shmoergh/moduleur/modules/06-utils-output/experimental/ui-l+r-out/utils-output-ui.kicad_pcb

## KiCad design modules/06-utils-output/experimental/ui-l+r-out/utils-output-ui.kicad_pcb (2026-05-13)

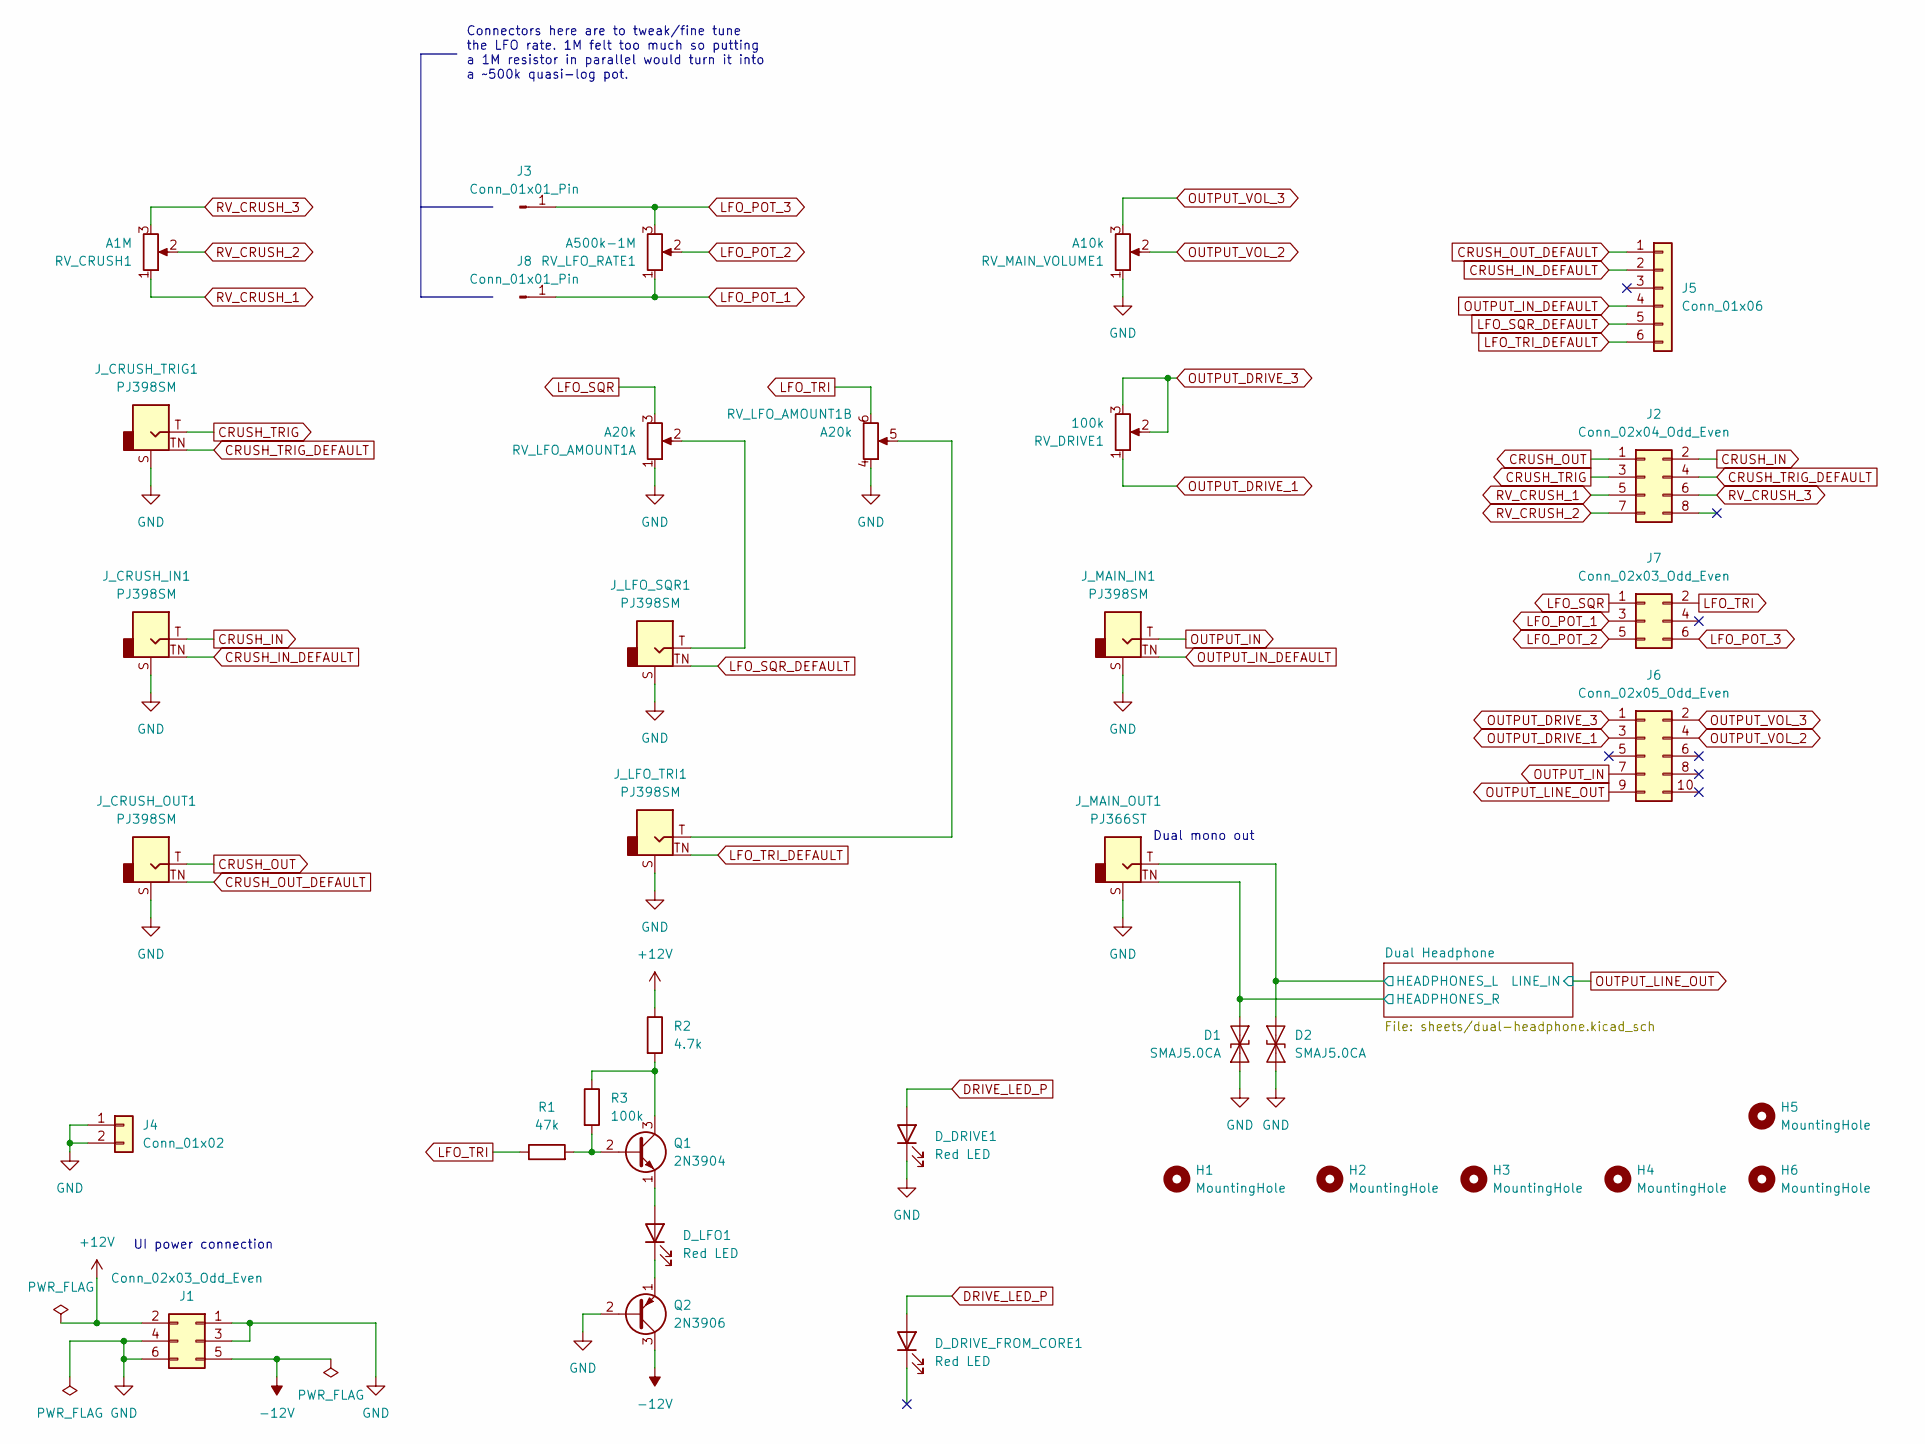
[picture p18: schematic utils-output-ui.kicad_sch, Utils + Output UI]

Parts:
D1, D2: SMAJ5.0CA; D_SMA
D_DRIVE1: Red LED; LED_D3.0mm
D_DRIVE_FROM_CORE1: Red LED; PinSocket_1x02_P2.54mm_Vertical
D_LFO1: Red LED; LED_D3.0mm
H1, H2, H3, H4, H5, H6: MountingHole; MountingHole_3.2mm_M3_DIN965_Pad
J1, J7: Conn_02x03_Odd_Even; PinSocket_2x03_P2.54mm_Vertical; Part no. 200-SSW10301TD
J2: Conn_02x04_Odd_Even; PinSocket_2x04_P2.54mm_Vertical; Part no. 200-SSW10401TD
J3, J8: Conn_01x01_Pin; TestPoint_THTPad_D2.0mm_Drill1.0mm
J4: Conn_01x02; PinSocket_1x02_P2.54mm_Vertical; Part no. 200-SSW10201TS
J5: Conn_01x06; PinSocket_1x06_P2.54mm_Vertical; Part no. 200-SSW10601TS
J6: Conn_02x05_Odd_Even; PinSocket_2x05_P2.54mm_Vertical; Part no. 200-SSW10501TD
J_CRUSH_IN1: PJ398SM; Jack_3.5mm_QingPu_WQP-PJ398SM_Vertical_CircularHoles; Part no. PJ398SM
J_CRUSH_OUT1: PJ398SM; Jack_3.5mm_QingPu_WQP-PJ398SM_Vertical_CircularHoles; Part no. PJ398SM
J_CRUSH_TRIG1: PJ398SM; Jack_3.5mm_QingPu_WQP-PJ398SM_Vertical_CircularHoles; Part no. PJ398SM
J_LFO_SQR1: PJ398SM; Jack_3.5mm_QingPu_WQP-PJ398SM_Vertical_CircularHoles; Part no. PJ398SM
J_LFO_TRI1: PJ398SM; Jack_3.5mm_QingPu_WQP-PJ398SM_Vertical_CircularHoles; Part no. PJ398SM
J_MAIN_IN1: PJ398SM; Jack_3.5mm_QingPu_WQP-PJ398SM_Vertical_CircularHoles; Part no. PJ398SM
J_MAIN_OUT1: PJ366ST; Jack_3.5mm_QingPu_WQP-PJ398SM_Vertical_CircularHoles; Part no. PJ366ST
Q1: 2N3904; TO-92_Inline_Wide; Part no. 637-2N3904
Q2: 2N3906; TO-92_Inline_Wide; Part no. 637-2N3906
R1: 47k; R_Axial_DIN0207_L6.3mm_D2.5mm_P7.62mm_Horizontal; Part no. 603-MFR-25FRF52-47K
R2: 4.7k; R_Axial_DIN0207_L6.3mm_D2.5mm_P7.62mm_Horizontal; Part no. 603-MFR25SFTF52-4K7
R3: 100k; R_Axial_DIN0207_L6.3mm_D2.5mm_P7.62mm_Horizontal; Part no. 603-MFR25SFTF52-4K7
RV_CRUSH1: A1M; Potentiometer_Bourns_Single-PTV09A; Part no. 652-PTV09A4025FA105
RV_DRIVE1: 100k; Potentiometer_Bourns_Single-PTV09A; Part no. 652-PTV09A4025UB104
RV_LFO_AMOUNT1: A20k; Potentiometer_Bourns_Dual-PTV112-4; Part No. 652-PTV1124425AA203
RV_LFO_RATE1: A500k-1M; Potentiometer_Bourns_Single-PTV09A; Part no. 652-PTV09A4025FA105
RV_MAIN_VOLUME1: A10k; Potentiometer_Bourns_Single-PTV09A; Part no. 652-PTV09A4025FA103

Connections:
+12V: J1.2, R2.1; also elsewhere on the board
-12V: J1.5, Q2.3 (C); also elsewhere on the board
/Dual Headphone/HEADPHONES_L: D2.2 (A2), J_MAIN_OUT1.T; also elsewhere on the board
/Dual Headphone/HEADPHONES_R: D1.2 (A2), J_MAIN_OUT1.TN; also elsewhere on the board
CRUSH_IN: J2.2, J_CRUSH_IN1.T
CRUSH_IN_DEFAULT: J5.2, J_CRUSH_IN1.TN
CRUSH_OUT: J2.1, J_CRUSH_OUT1.T
CRUSH_OUT_DEFAULT: J5.1, J_CRUSH_OUT1.TN
CRUSH_TRIG: J2.3, J_CRUSH_TRIG1.T
CRUSH_TRIG_DEFAULT: J2.4, J_CRUSH_TRIG1.TN
DRIVE_LED_P: D_DRIVE1.2 (A), D_DRIVE_FROM_CORE1.2 (A_2)
GND: D1.1 (A1), D2.1 (A1), D_DRIVE1.1 (K), J1.1, J1.3, J1.4, J1.6, J4.1, J4.2, J_CRUSH_IN1.S, J_CRUSH_OUT1.S, J_CRUSH_TRIG1.S, J_LFO_SQR1.S, J_LFO_TRI1.S, J_MAIN_IN1.S, J_MAIN_OUT1.S, Q2.2 (B), RV_LFO_AMOUNT1.1, RV_LFO_AMOUNT1.4, RV_MAIN_VOLUME1.1; also elsewhere on the board
LFO_POT_1: J7.3, J8.1 (Pin_1_1), RV_LFO_RATE1.1
LFO_POT_2: J7.5, RV_LFO_RATE1.2
LFO_POT_3: J3.1 (Pin_1_1), J7.6, RV_LFO_RATE1.3
LFO_SQR: J7.1, RV_LFO_AMOUNT1.3
LFO_SQR_DEFAULT: J5.5, J_LFO_SQR1.TN
LFO_TRI: J7.2, R1.1, RV_LFO_AMOUNT1.6
LFO_TRI_DEFAULT: J5.6, J_LFO_TRI1.TN
unnamed: D_LFO1.2 (A), Q1.1 (E)
unnamed: D_LFO1.1 (K), Q2.1 (E)
unnamed: J_LFO_SQR1.T, RV_LFO_AMOUNT1.2
unnamed: J_LFO_TRI1.T, RV_LFO_AMOUNT1.5
unnamed: Q1.2 (B), R1.2, R3.2
unnamed: Q1.3 (C), R2.2, R3.1
OUTPUT_DRIVE_1: J6.3, RV_DRIVE1.1
OUTPUT_DRIVE_3: J6.1, RV_DRIVE1.2, RV_DRIVE1.3
OUTPUT_IN: J6.7, J_MAIN_IN1.T
OUTPUT_IN_DEFAULT: J5.4, J_MAIN_IN1.TN
OUTPUT_LINE_OUT: J6.9; also elsewhere on the board
OUTPUT_VOL_2: J6.4, RV_MAIN_VOLUME1.2
OUTPUT_VOL_3: J6.2, RV_MAIN_VOLUME1.3
RV_CRUSH_1: J2.5, RV_CRUSH1.1
RV_CRUSH_2: J2.7, RV_CRUSH1.2
RV_CRUSH_3: J2.6, RV_CRUSH1.3

Notes on the sheet:
Dual mono out
Connectors here are to tweak/fine tune the LFO rate. 1M felt too much so putting a 1M resistor in parallel would turn it into a ~500k quasi-log pot.
UI power connection

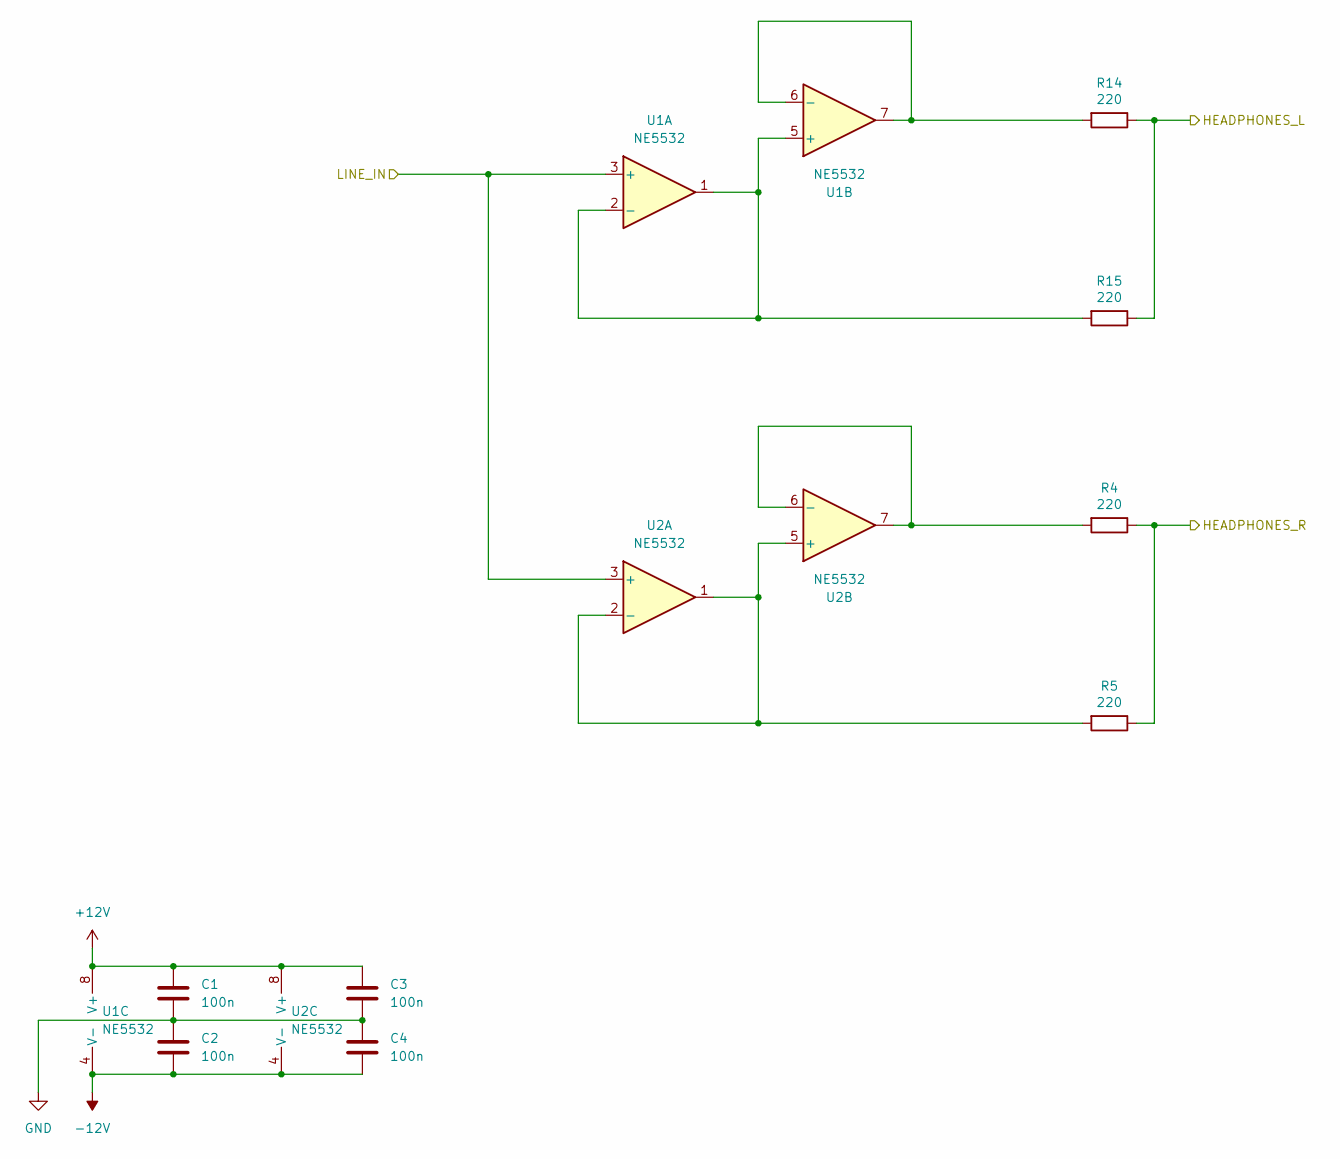
[picture p19: schematic dual-headphone.kicad_sch, Utils + Output UI]

Parts:
C1, C2, C3, C4: 100n; C_1206_3216Metric_Pad1.33x1.80mm_HandSolder; Part No. 80-C1206C104J5RAC
R4, R5, R14, R15: 220; R_1206_3216Metric_Pad1.30x1.75mm_HandSolder; Part No. 652-CR1206JW-221ELF
U1, U2: NE5532; SOIC-8_3.9x4.9mm_P1.27mm; Part No. 595-NE5532DR

Connections:
+12V: C1.1, C3.1, U1.8 (V+), U2.8 (V+); also elsewhere on the board
-12V: C2.2, C4.2, U1.4 (V-), U2.4 (V-); also elsewhere on the board
/Dual Headphone/HEADPHONES_L: R14.1, R15.1; also elsewhere on the board
/Dual Headphone/HEADPHONES_R: R4.1, R5.1; also elsewhere on the board
GND: C1.2, C2.1, C3.2, C4.1; also elsewhere on the board
unnamed: R15.2, U1.1, U1.2 (-), U1.5 (+)
unnamed: R14.2, U1.6 (-), U1.7
unnamed: R5.2, U2.1, U2.2 (-), U2.5 (+)
unnamed: R4.2, U2.6 (-), U2.7
OUTPUT_LINE_OUT: U1.3 (+), U2.3 (+); also elsewhere on the board

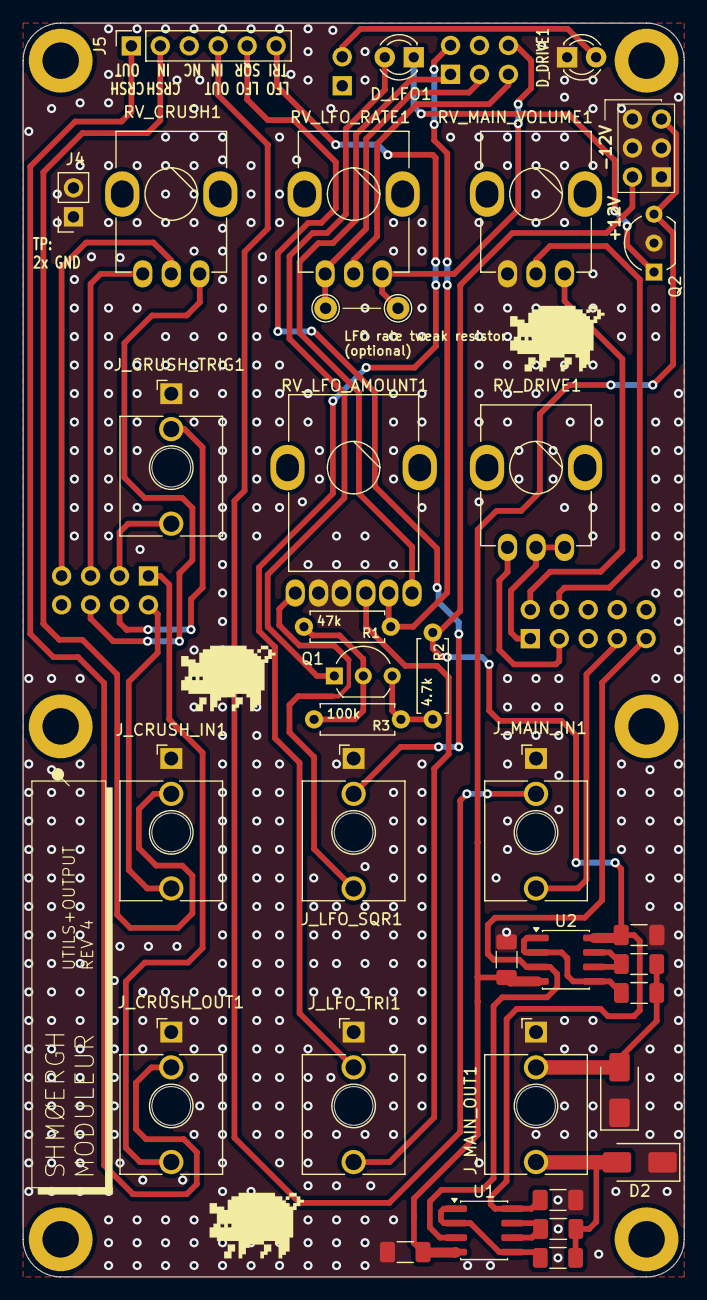
[picture p20: board utils-output-ui.kicad_pcb from above]

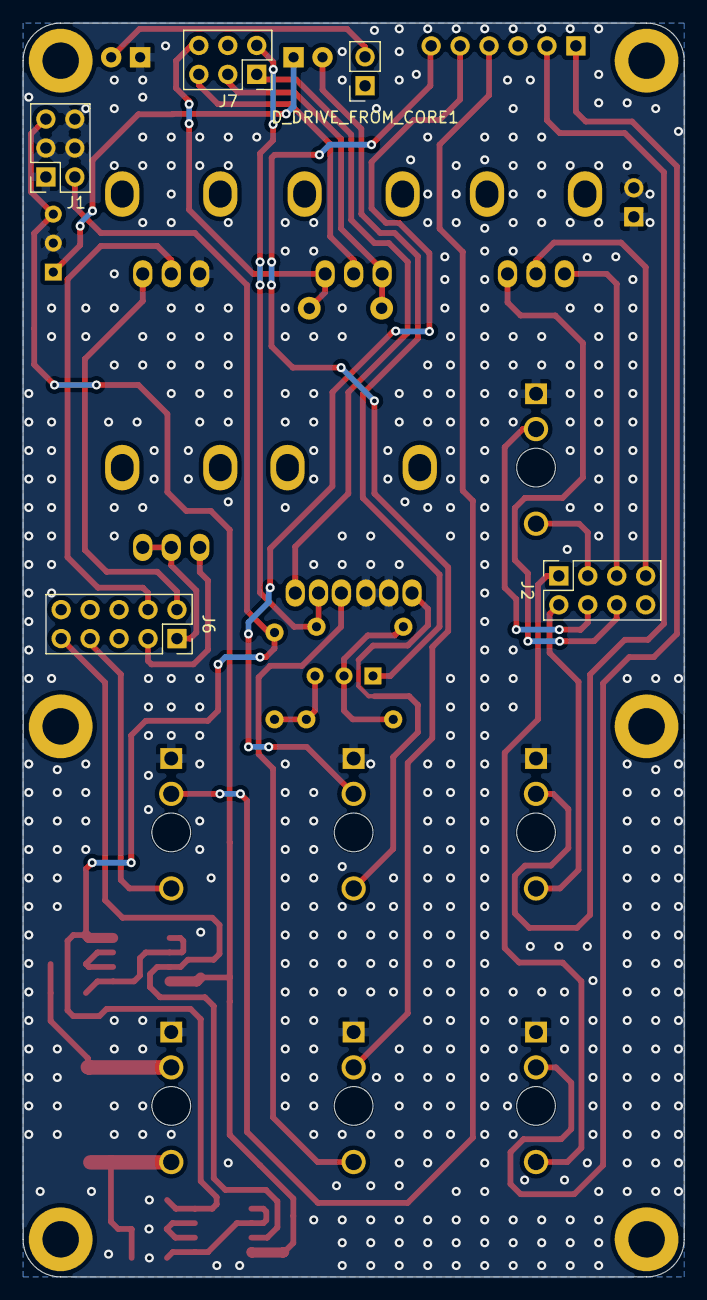
[picture p21: board utils-output-ui.kicad_pcb from below]

Board: 2 copper layers, 58.0 x 110.0 mm, 46 parts (5 on the bottom side), 39 nets.
