shmoergh/moduleur/modules/05-adsr-vca/electronics/ui/adsr-vca-ui.kicad_pcb

## KiCad design modules/05-adsr-vca/electronics/ui/adsr-vca-ui.kicad_pcb (2026-05-13)

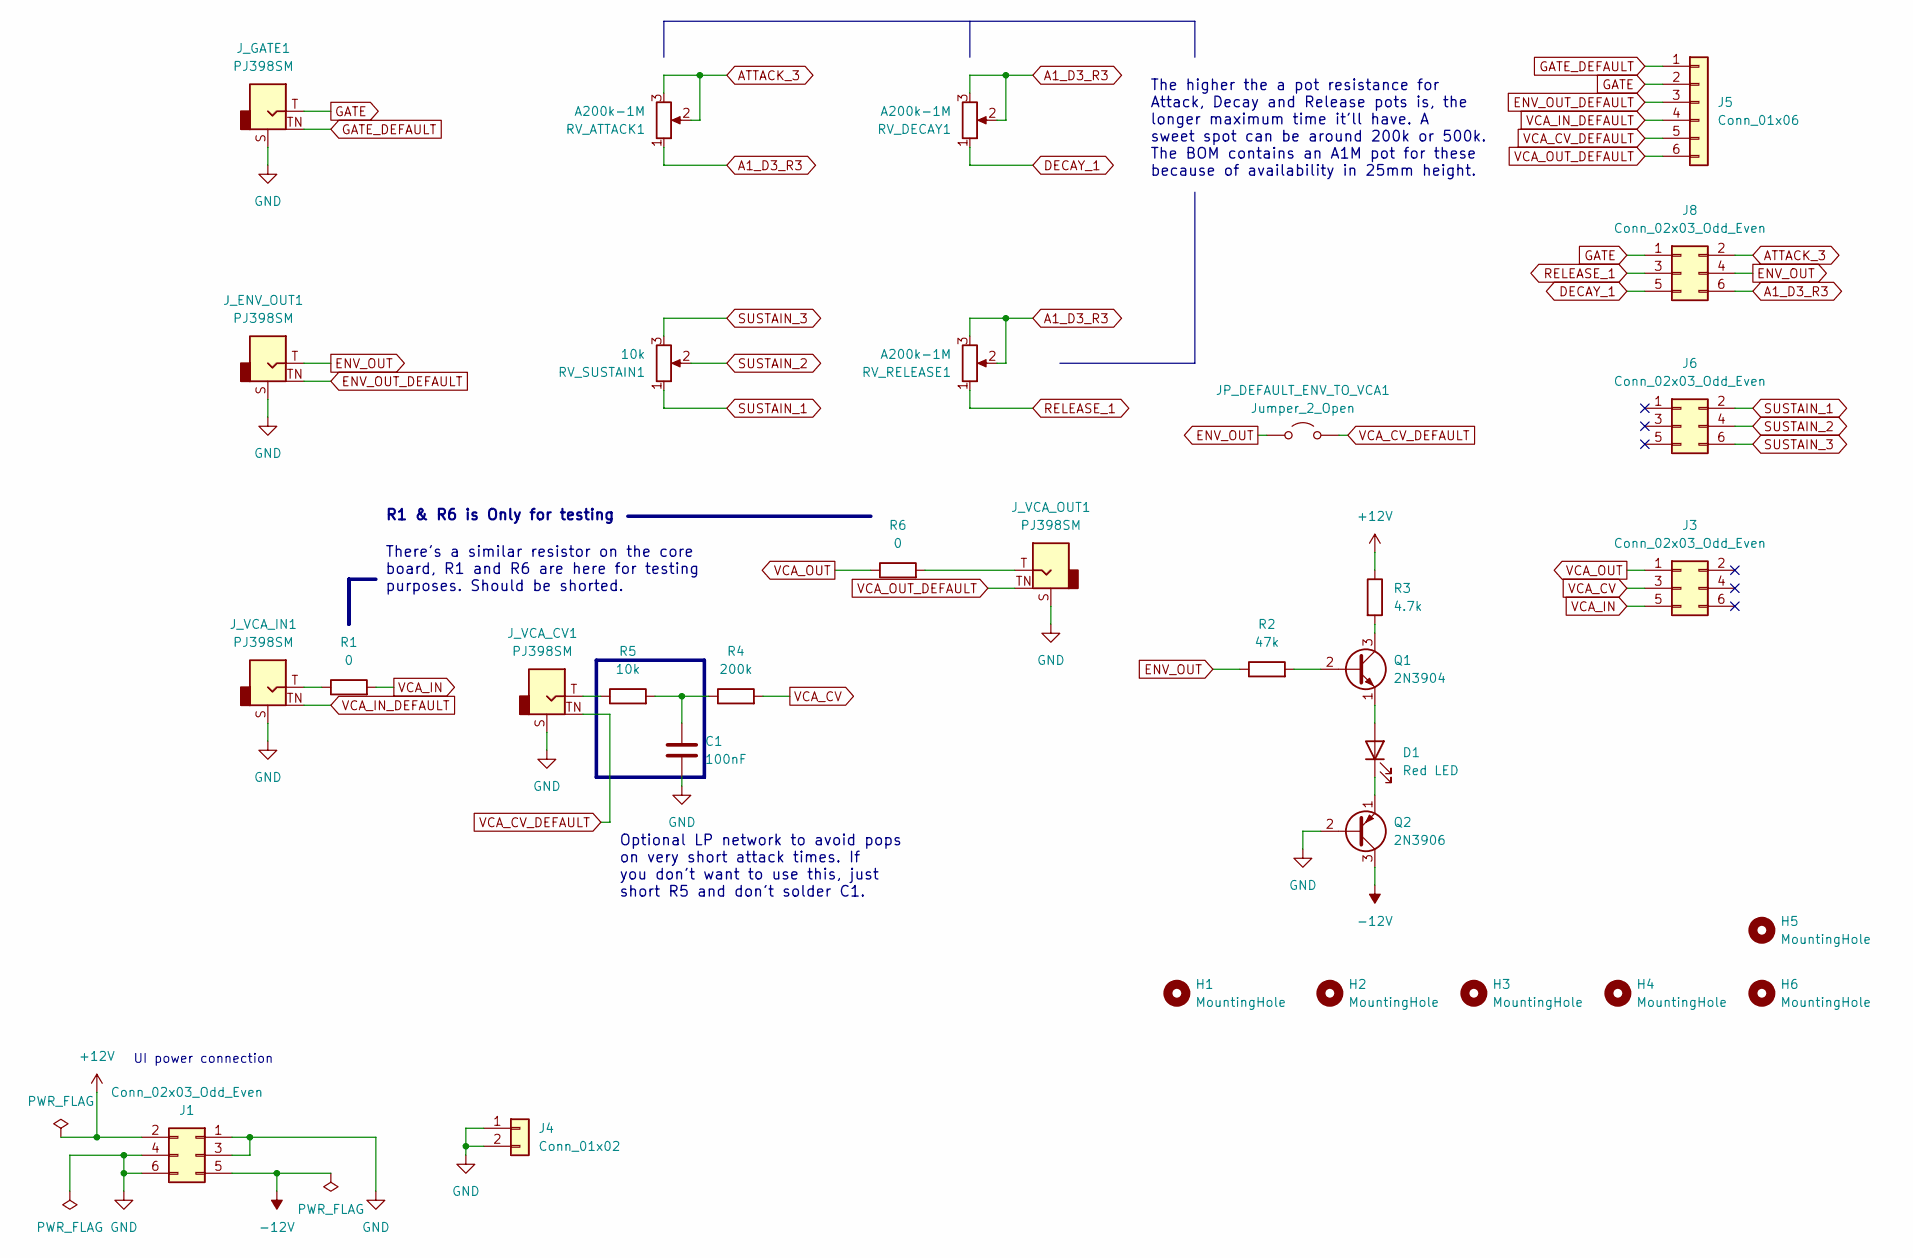
[picture p28: schematic adsr-vca-ui.kicad_sch, ADSR + VCA UI]

Parts:
C1: 100nF; C_Rect_L7.2mm_W2.5mm_P5.00mm_FKS2_FKP2_MKS2_MKP2; Part no. 80-MMK5104J50J01L16
D1: Red LED; LED_D3.0mm
H1, H2, H3, H4, H5, H6: MountingHole; MountingHole_3.2mm_M3_DIN965_Pad
J1, J3, J6, J8: Conn_02x03_Odd_Even; PinSocket_2x03_P2.54mm_Vertical; Part no. 200-SSW10301TD
J4: Conn_01x02; PinSocket_1x02_P2.54mm_Vertical; Part no. 200-SSW10201TS
J5: Conn_01x06; PinSocket_1x06_P2.54mm_Vertical; Part no. 200-SSW10601TS
JP_DEFAULT_ENV_TO_VCA1: Jumper_2_Open; PinHeader_1x02_P2.54mm_Horizontal; Part no. 200-HTSW10208TSRA
J_ENV_OUT1: PJ398SM; Jack_3.5mm_QingPu_WQP-PJ398SM_Vertical_CircularHoles; Part no. PJ398SM
J_GATE1: PJ398SM; Jack_3.5mm_QingPu_WQP-PJ398SM_Vertical_CircularHoles; Part no. PJ398SM
J_VCA_CV1: PJ398SM; Jack_3.5mm_QingPu_WQP-PJ398SM_Vertical_CircularHoles; Part no. PJ398SM
J_VCA_IN1: PJ398SM; Jack_3.5mm_QingPu_WQP-PJ398SM_Vertical_CircularHoles; Part no. PJ398SM
J_VCA_OUT1: PJ398SM; Jack_3.5mm_QingPu_WQP-PJ398SM_Vertical_CircularHoles; Part no. PJ398SM
Q1: 2N3904; TO-92_Inline_Wide; Part no. 637-2N3904
Q2: 2N3906; TO-92_Inline_Wide; Part no. 637-2N3906
R1: 0; R_Axial_DIN0207_L6.3mm_D2.5mm_P7.62mm_Horizontal; Part no. 603-MFR-25FRF52100K
R2: 47k; R_Axial_DIN0207_L6.3mm_D2.5mm_P7.62mm_Horizontal; Part no. 603-MFR-25FRF52-47K
R3: 4.7k; R_Axial_DIN0207_L6.3mm_D2.5mm_P7.62mm_Horizontal; Part no. 603-MFR25SFTF52-4K7
R4: 200k; R_Axial_DIN0207_L6.3mm_D2.5mm_P7.62mm_Horizontal; Part no. 603-MFR-25FRF52200K
R5: 10k; R_Axial_DIN0207_L6.3mm_D2.5mm_P7.62mm_Horizontal; Part no. 603-MFR-25FRF5210K
R6: 0; R_Axial_DIN0207_L6.3mm_D2.5mm_P7.62mm_Horizontal; Part no. 603-MFR-25FRF52-47K
RV_ATTACK1: A200k-1M; Potentiometer_Bourns_Single-PTV09A; Part no. 652-PTV09A4025FA105
RV_DECAY1: A200k-1M; Potentiometer_Bourns_Single-PTV09A; Part no. 652-PTV09A4025FA105
RV_RELEASE1: A200k-1M; Potentiometer_Bourns_Single-PTV09A; Part no. 652-PTV09A4025FA105
RV_SUSTAIN1: 10k; TRIM_PTA4543-2015DPB103; Part no. 652-PTA4432015CPB103

Connections:
+12V: J1.2, R3.1
-12V: J1.5, Q2.3 (C)
A1_D3_R3: J8.6, RV_ATTACK1.1, RV_DECAY1.2, RV_DECAY1.3, RV_RELEASE1.2, RV_RELEASE1.3
ATTACK_3: J8.2, RV_ATTACK1.2, RV_ATTACK1.3
DECAY_1: J8.5, RV_DECAY1.1
ENV_OUT: J8.4, JP_DEFAULT_ENV_TO_VCA1.1 (A), J_ENV_OUT1.T, R2.1
ENV_OUT_DEFAULT: J5.3, J_ENV_OUT1.TN
GATE: J5.2, J8.1, J_GATE1.T
GATE_DEFAULT: J5.1, J_GATE1.TN
GND: C1.2, J1.1, J1.3, J1.4, J1.6, J4.1, J4.2, J_ENV_OUT1.S, J_GATE1.S, J_VCA_CV1.S, J_VCA_IN1.S, J_VCA_OUT1.S, Q2.2 (B)
unnamed: C1.1, R4.1, R5.2
unnamed: D1.2 (A), Q1.1 (E)
unnamed: D1.1 (K), Q2.1 (E)
unnamed: J_VCA_CV1.T, R5.1
unnamed: J_VCA_IN1.T, R1.1
unnamed: J_VCA_OUT1.T, R6.2
unnamed: Q1.2 (B), R2.2
unnamed: Q1.3 (C), R3.2
RELEASE_1: J8.3, RV_RELEASE1.1
SUSTAIN_1: J6.2, RV_SUSTAIN1.1
SUSTAIN_2: J6.4, RV_SUSTAIN1.2
SUSTAIN_3: J6.6, RV_SUSTAIN1.3
VCA_CV: J3.3, R4.2
VCA_CV_DEFAULT: J5.5, JP_DEFAULT_ENV_TO_VCA1.2 (B), J_VCA_CV1.TN
VCA_IN: J3.5, R1.2
VCA_IN_DEFAULT: J5.4, J_VCA_IN1.TN
VCA_OUT: J3.1, R6.1
VCA_OUT_DEFAULT: J5.6, J_VCA_OUT1.TN

Notes on the sheet:
There's a similar resistor on the core board, R1 and R6 are here for testing purposes. Should be shorted.
R1 & R6 is Only for testing
UI power connection
The higher the a pot resistance for Attack, Decay and Release pots is, the longer maximum time it'll have. A sweet spot can be around 200k or 500k. The BOM contains an A1M pot for these because of availability in 25mm height.
Optional LP network to avoid pops on very short attack times. If you don't want to use this, just short R5 and don't solder C1.

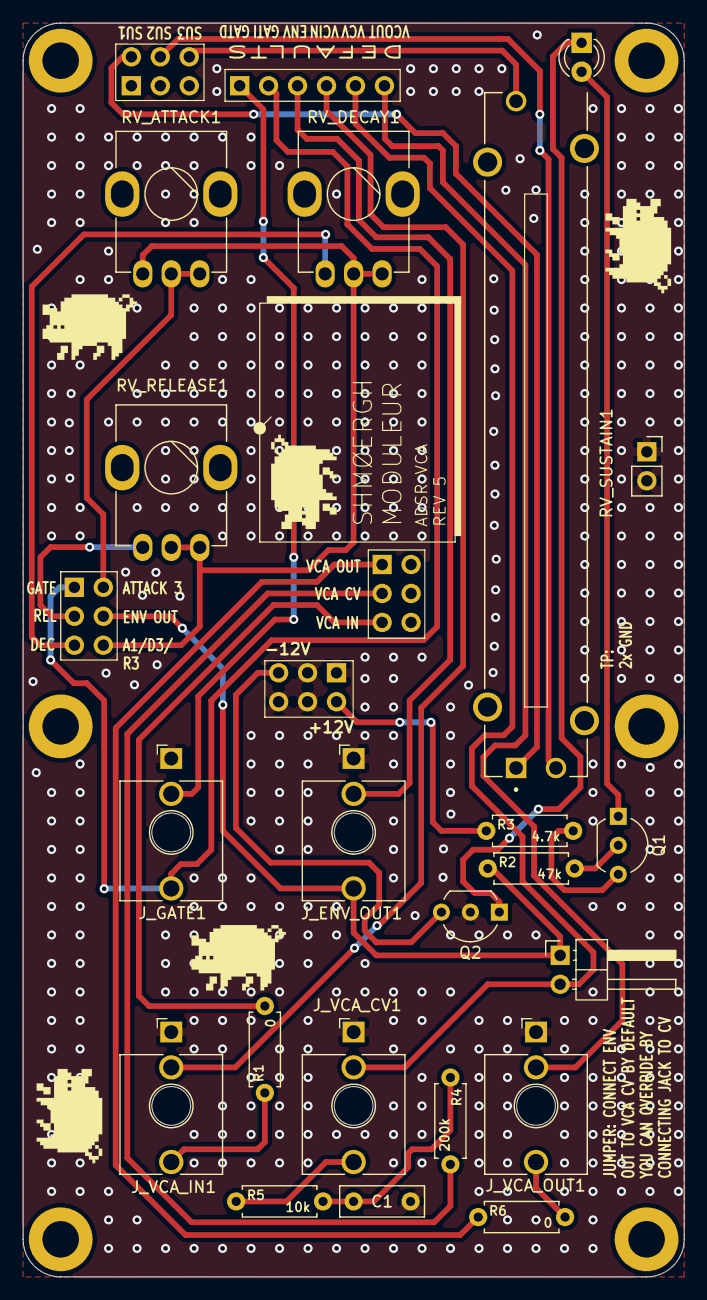
[picture p29: board adsr-vca-ui.kicad_pcb from above]

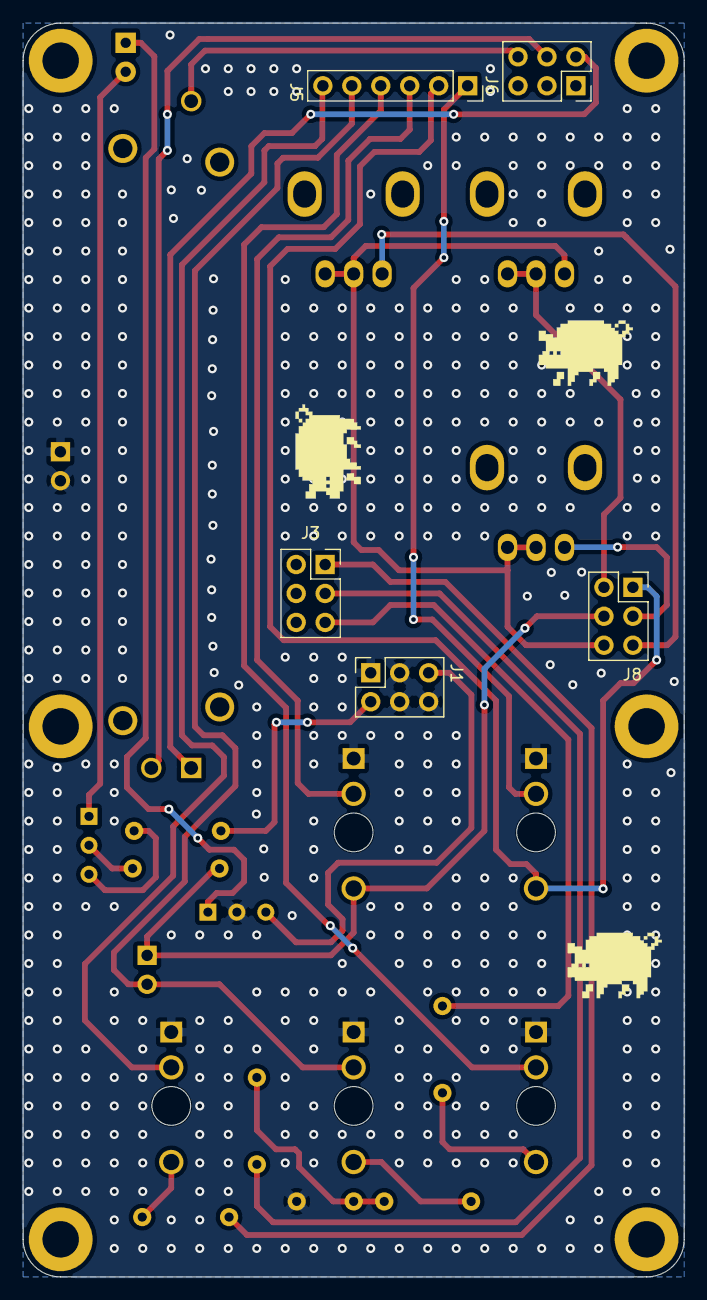
[picture p30: board adsr-vca-ui.kicad_pcb from below]

Board: 2 copper layers, 58.0 x 110.0 mm, 32 parts (5 on the bottom side), 28 nets.
