shmoergh/moduleur/modules/03-sidechain-mixer/electronics/core/sidechain-mixer-core.kicad_pcb

## KiCad design modules/03-sidechain-mixer/electronics/core/sidechain-mixer-core.kicad_pcb (2026-05-13)

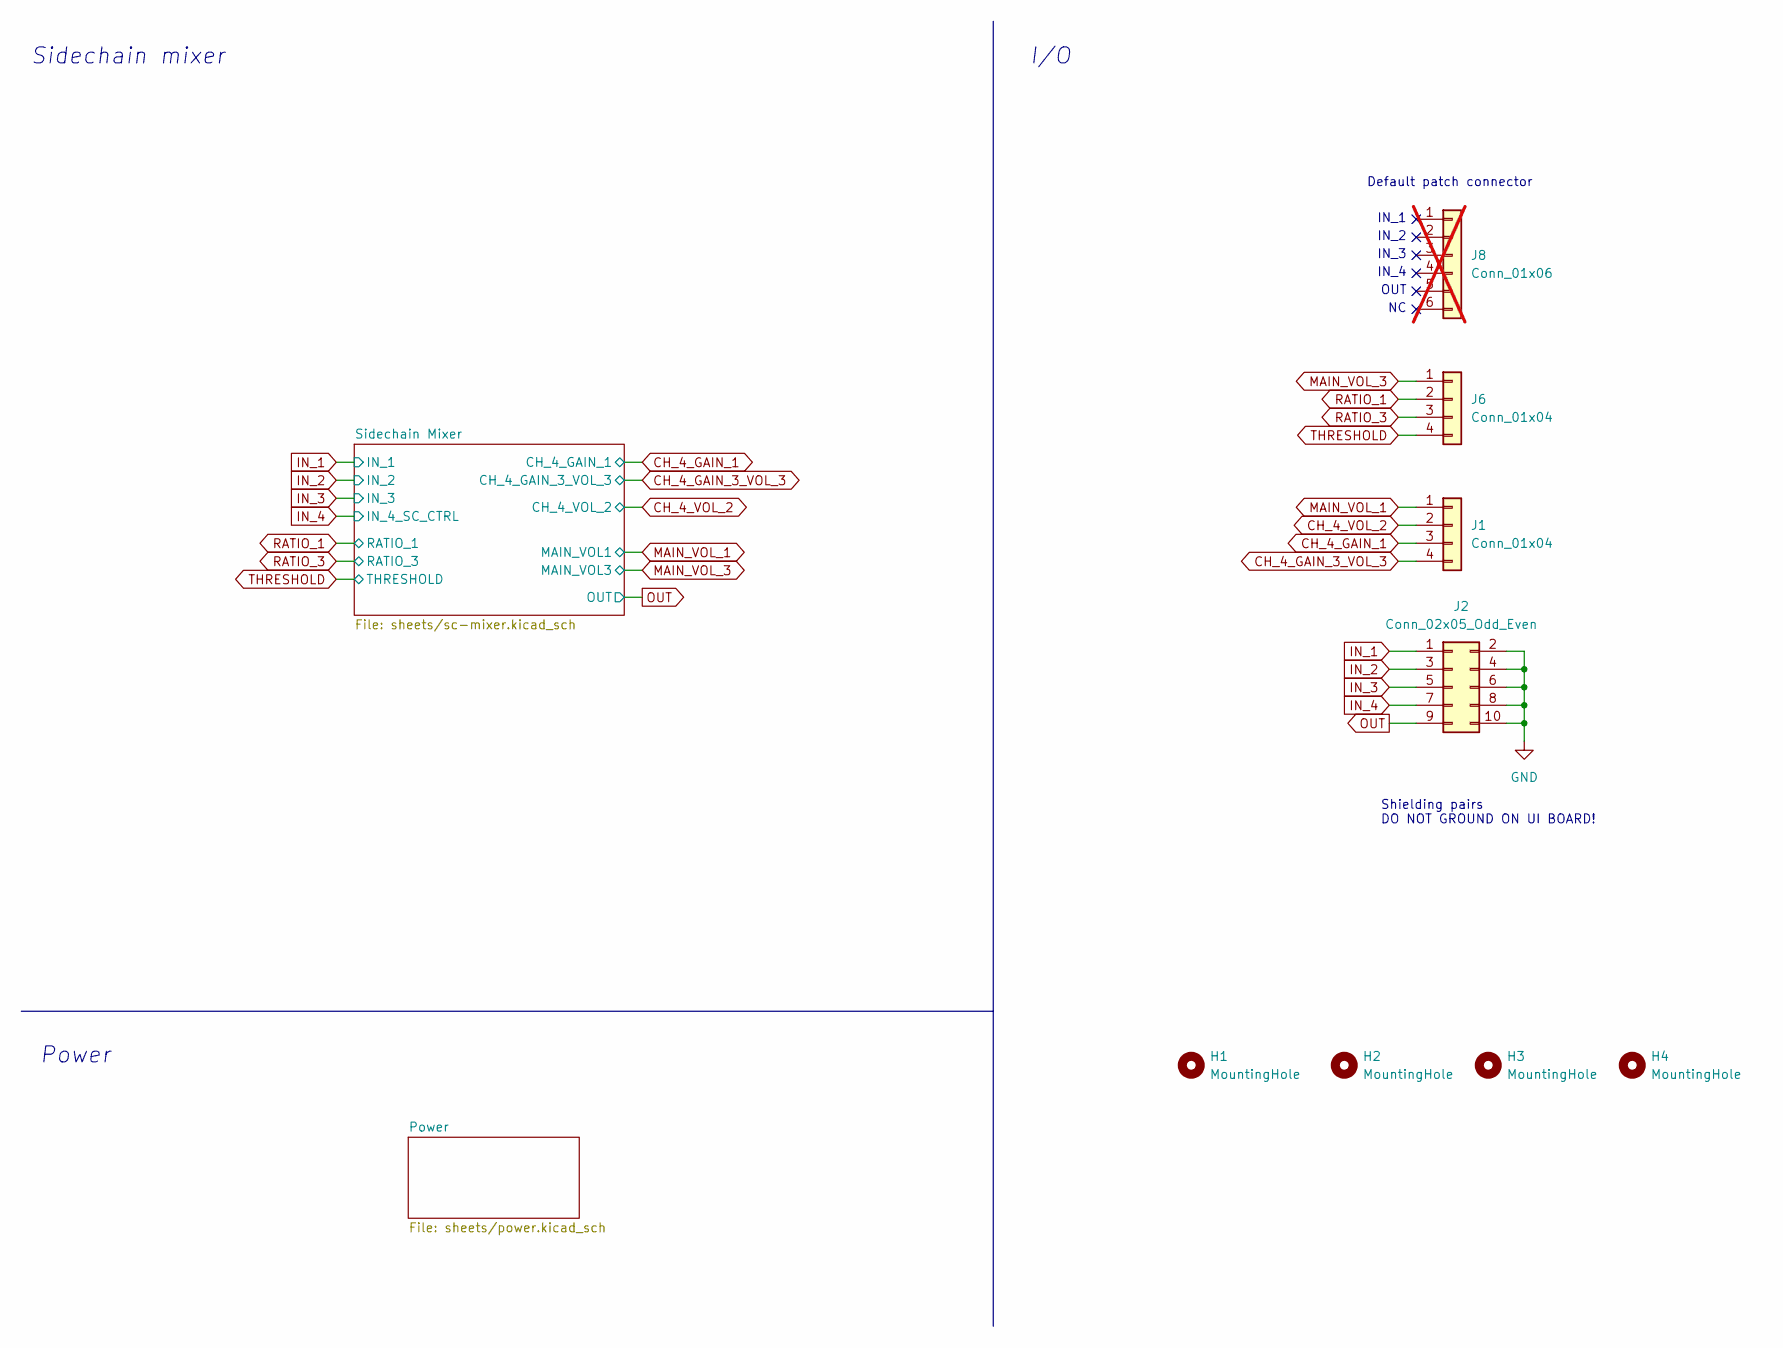
[picture p40: schematic sidechain-mixer-core.kicad_sch, Moduleur Mixer & sidechain compressor]

Parts:
H1, H2, H3, H4: MountingHole; MountingHole_3.2mm_M3_DIN965_Pad
J1, J6: Conn_01x04; PinHeader_1x04_P2.54mm_Vertical; Mouser Part no. 200-HTSW10407TS
J2: Conn_02x05_Odd_Even; PinHeader_2x05_P2.54mm_Vertical; Mouser Part no. 200-HTSW10507TD
J8: Conn_01x06; PinHeader_1x06_P2.54mm_Vertical; Mouser Part no. 200-HTSW10607TS; not fitted

Connections:
CH_4_GAIN_1: J1.3; also elsewhere on the board
CH_4_GAIN_3_VOL_3: J1.4; also elsewhere on the board
CH_4_VOL_2: J1.2; also elsewhere on the board
IN_1: J2.1; also elsewhere on the board
IN_2: J2.3; also elsewhere on the board
IN_3: J2.5; also elsewhere on the board
IN_4: J2.7; also elsewhere on the board
MAIN_VOL_1: J1.1; also elsewhere on the board
MAIN_VOL_3: J6.1; also elsewhere on the board
OUT: J2.9; also elsewhere on the board
RATIO_1: J6.2; also elsewhere on the board
RATIO_3: J6.3; also elsewhere on the board
THRESHOLD: J6.4; also elsewhere on the board

Notes on the sheet:
Power
IN_3
Default patch connector
IN_1
Shielding pairs DO NOT GROUND ON UI BOARD!
OUT
Sidechain mixer
IN_2
I/O
IN_4

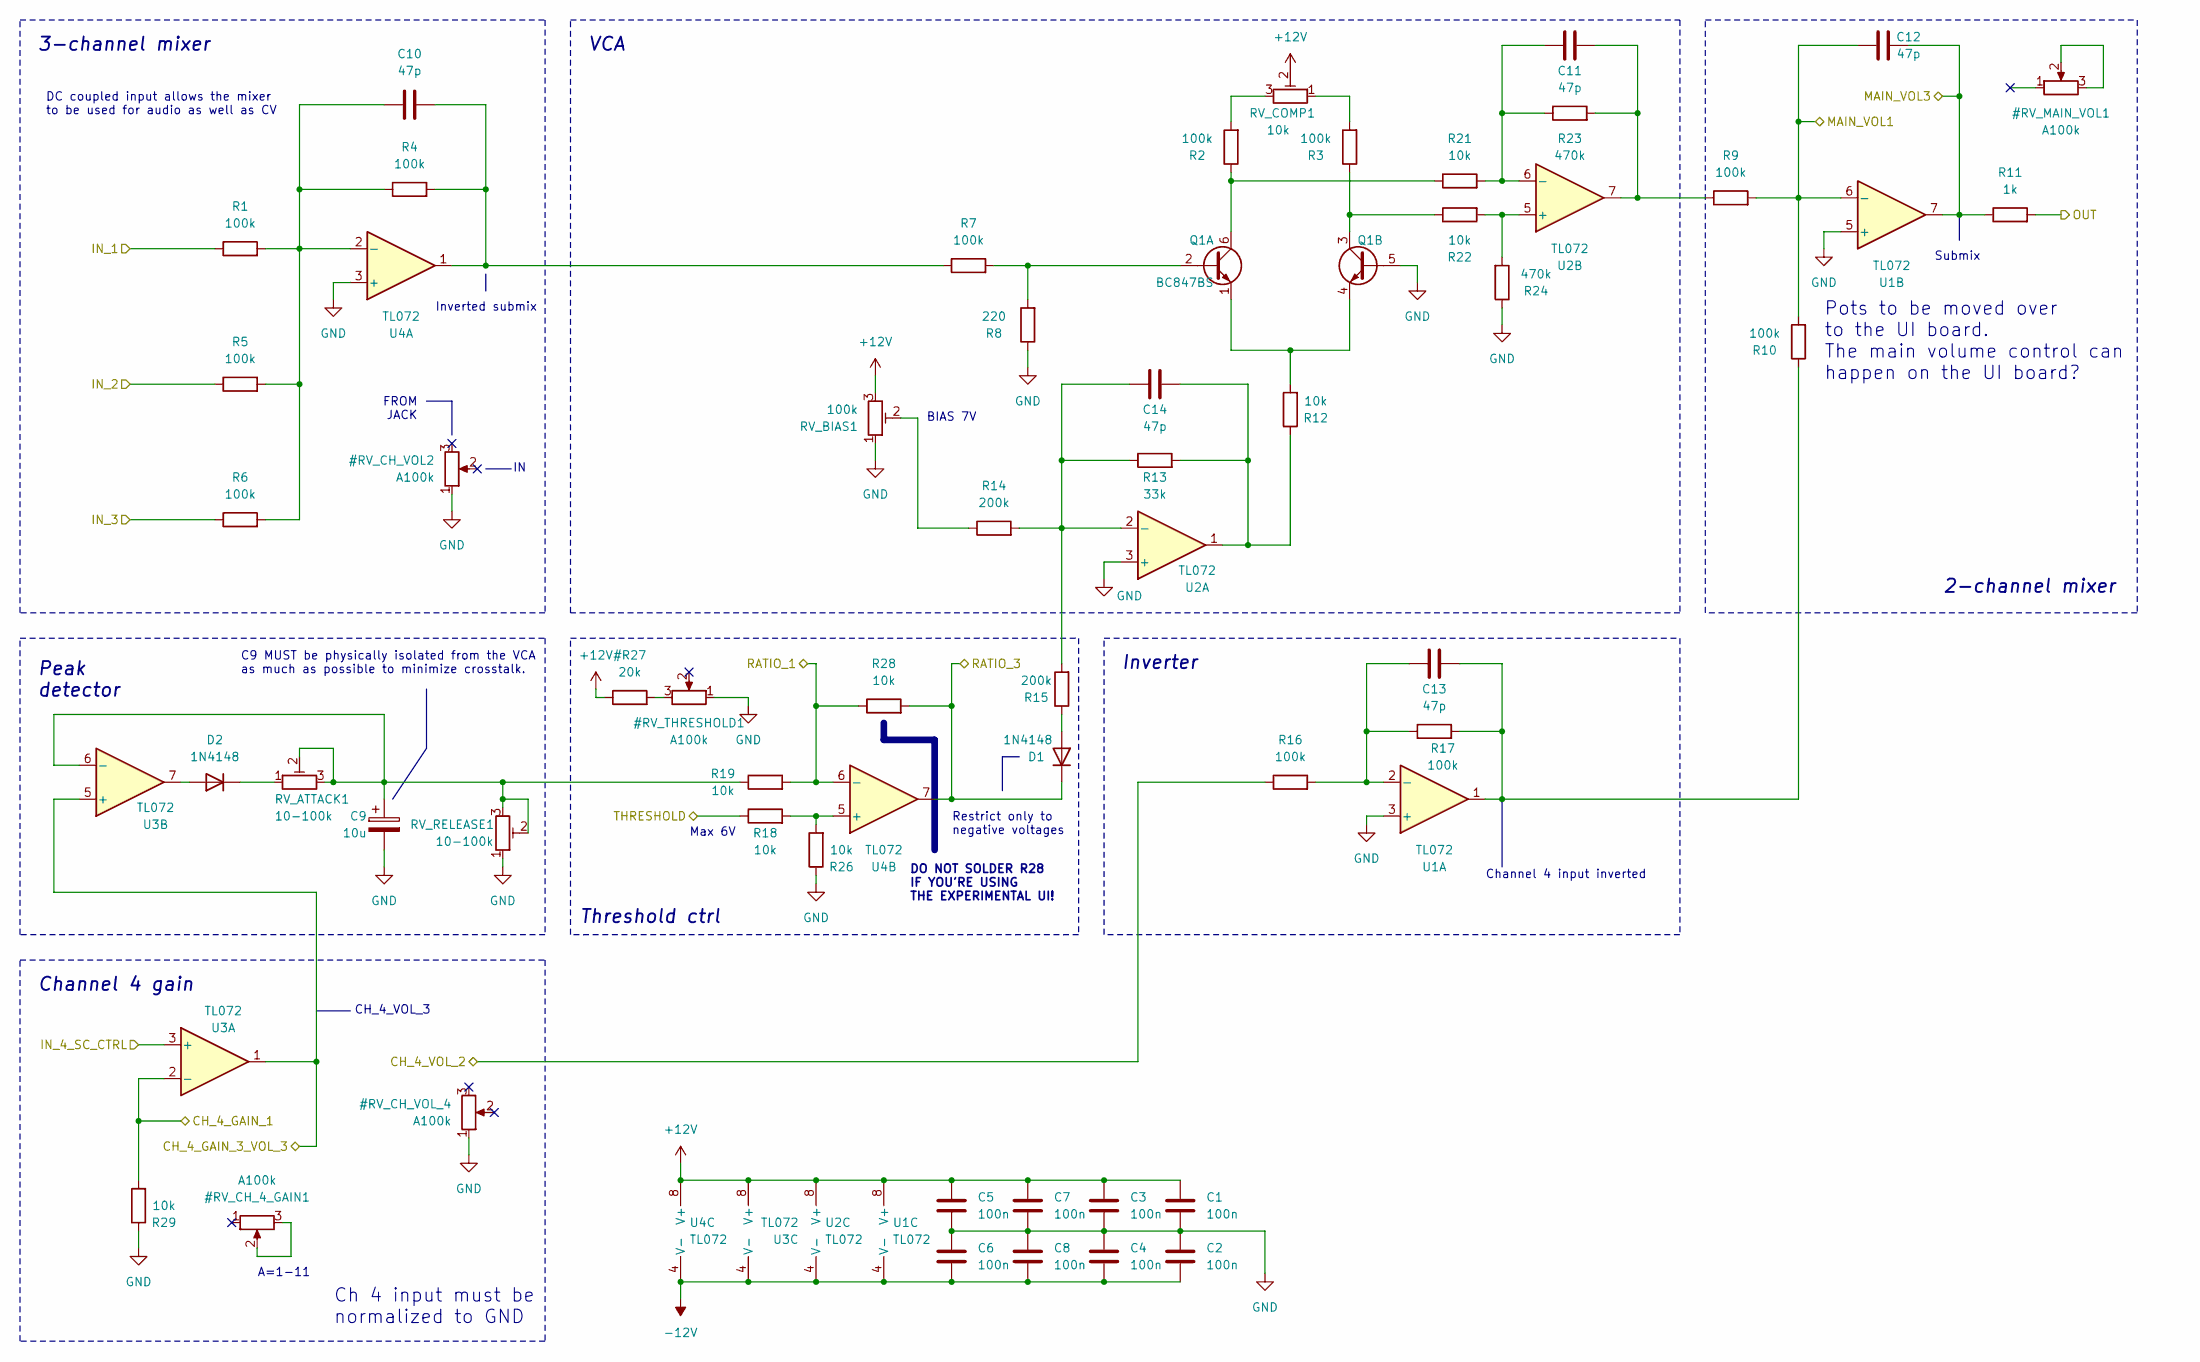
[picture p41: schematic sc-mixer.kicad_sch, Moduleur Mixer & sidechain compressor]

Parts:
C1, C2, C3, C4, C5, C6, C7, C8: 100n; C_0603_1608Metric; LCSC C14663
C9: 10u; CP_Elec_5x5.4; LCSC C30110
C10, C11, C12, C13, C14: 47p; C_0603_1608Metric_Pad1.08x0.95mm_HandSolder; LCSC C1671
D1, D2: 1N4148; D_SOD-123; LCSC C81598
Q1: BC847BS; SOT-363_SC-70-6; LCSC C5380687
R1, R2, R3, R4, R5, R6, R7, R9, R10, R16, R17: 100k; R_0603_1608Metric; LCSC C25803
R8: 220; R_0603_1608Metric; LCSC C22962
R11: 1k; R_0603_1608Metric; LCSC C21190
R12, R21, R22: 10k; R_0603_1608Metric; LCSC C25804
R13: 33k; R_0603_1608Metric; LCSC C4216
R14, R15: 200k; R_0603_1608Metric; LCSC C25811
R18, R19, R26, R28, R29: 10k; R_Axial_DIN0207_L6.3mm_D2.5mm_P7.62mm_Horizontal; Mouser Part no. 603-MFR-25FRF5210K
R23, R24: 470k; R_0603_1608Metric; LCSC C23178
RV_ATTACK1: 10-100k; Potentiometer_ACP_CA6-H2,5_Horizontal; Mouser Part no. 774-06TR4AA103CP
RV_BIAS1: 100k; Potentiometer_ACP_CA6-H2,5_Horizontal; Mouser Part no. 774-06TR4AA104CP
RV_COMP1: 10k; Potentiometer_ACP_CA6-H2,5_Horizontal; Mouser Part no. 774-06TR4AA103CP
RV_RELEASE1: 10-100k; Potentiometer_ACP_CA6-H2,5_Horizontal; Mouser Part no. 774-06TR4AA103CP
U1, U2, U3, U4: TL072; SOIC-8_3.9x4.9mm_P1.27mm; LCSC C6961

Connections:
-12V: C2.2, C4.2, C6.2, C8.2, U1.4 (V-), U2.4 (V-), U3.4 (V-), U4.4 (V-); also elsewhere on the board
CH_4_GAIN_1: R29.2, U3.2 (-); also elsewhere on the board
CH_4_GAIN_3_VOL_3: U3.1, U3.5 (+); also elsewhere on the board
CH_4_VOL_2: R16.1; also elsewhere on the board
IN_1: R1.1; also elsewhere on the board
IN_2: R5.1; also elsewhere on the board
IN_3: R6.1; also elsewhere on the board
IN_4: U3.3 (+); also elsewhere on the board
MAIN_VOL_1: C12.1, R9.2, R10.2, U1.6 (-); also elsewhere on the board
MAIN_VOL_3: C12.2, R11.1, U1.7; also elsewhere on the board
unnamed: C10.2, R4.2, R7.1, U4.1
unnamed: C11.2, R9.1, R23.2, U2.7
unnamed: C13.2, R10.1, R17.2, U1.1
unnamed: C14.2, R12.1, R13.2, U2.1
unnamed: D1.2 (A), R15.1
unnamed: D2.2 (A), U3.7
unnamed: D2.1 (K), RV_ATTACK1.1
unnamed: Q1.2 (B1), R7.2, R8.2
unnamed: Q1.6 (C1), R2.1, R21.1
unnamed: Q1.1 (E1), Q1.4 (E2), R12.2
unnamed: Q1.3 (C2), R3.1, R22.1
unnamed: R2.2, RV_COMP1.3
unnamed: R3.2, RV_COMP1.1
unnamed: R14.1, RV_BIAS1.2
unnamed: C13.1, R16.2, R17.1, U1.2 (-)
unnamed: C14.1, R13.1, R14.2, R15.2, U2.2 (-)
unnamed: R22.2, R24.2, U2.5 (+)
unnamed: C11.1, R21.2, R23.1, U2.6 (-)
unnamed: C9.1, R19.1, RV_ATTACK1.2, RV_ATTACK1.3, RV_RELEASE1.2, RV_RELEASE1.3, U3.6 (-)
unnamed: C10.1, R1.2, R4.1, R5.2, R6.2, U4.2 (-)
unnamed: R18.2, R26.2, U4.5 (+)
OUT: R11.2; also elsewhere on the board
RATIO_1: R19.2, R28.1, U4.6 (-); also elsewhere on the board
RATIO_3: D1.1 (K), R28.2, U4.7; also elsewhere on the board
THRESHOLD: R18.1; also elsewhere on the board

Notes on the sheet:
2-channel mixer
Channel 4 gain
FROM JACK
A=1-11
Pots to be moved over to the UI board. The main volume control can happen on the UI board?
DO NOT SOLDER R28 IF YOU'RE USING THE EXPERIMENTAL UI!
Inverter
Submix
VCA
BIAS 7V
Channel 4 input inverted
Max 6V
Ch 4 input must be normalized to GND
3-channel mixer
Restrict only to negative voltages
DC coupled input allows the mixer to be used for audio as well as CV
C9 MUST be physically isolated from the VCA as much as possible to minimize crosstalk.
CH_4_VOL_3
Peak detector
Threshold ctrl
Inverted submix

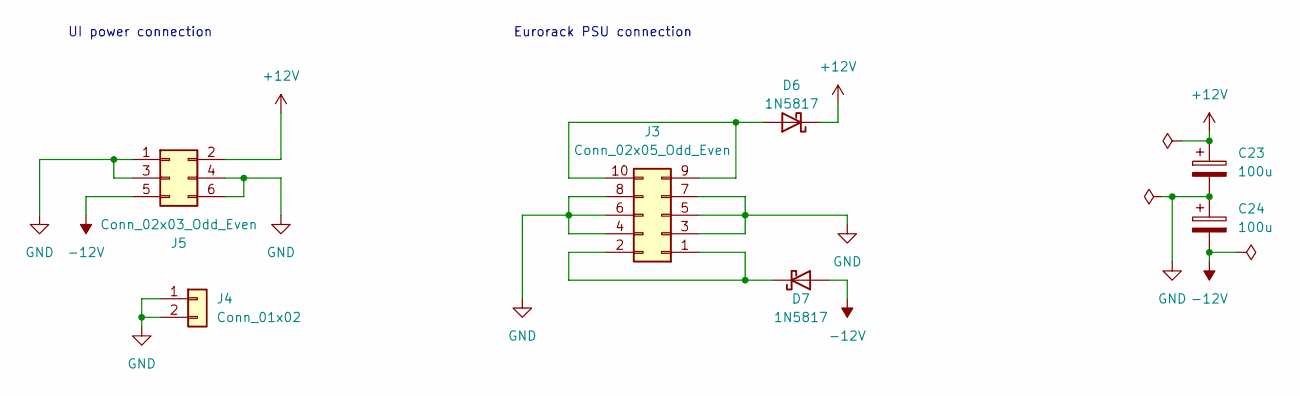
[picture p42: schematic power.kicad_sch, Moduleur Mixer & sidechain compressor]

Parts:
C23, C24: 100u; CP_Elec_6.3x7.7; LCSC C2836442
D6, D7: 1N5817; D_SOD-323; LCSC C5190152
J3: Conn_02x05_Odd_Even; IDC-Header_2x05_P2.54mm_Horizontal; Mouser Part no. 571-5103310-1
J4: Conn_01x02; PinHeader_1x02_P2.54mm_Vertical; Mouser Part no. 200-HTSW10207TS
J5: Conn_02x03_Odd_Even; PinHeader_2x03_P2.54mm_Vertical; Mouser Part no. 200-TSW10307TD

Connections:
-12V: C24.2, D7.2 (A), J5.5; also elsewhere on the board
unnamed: D6.2 (A), J3.9, J3.10
unnamed: D7.1 (K), J3.1, J3.2

Notes on the sheet:
UI power connection
Eurorack PSU connection

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
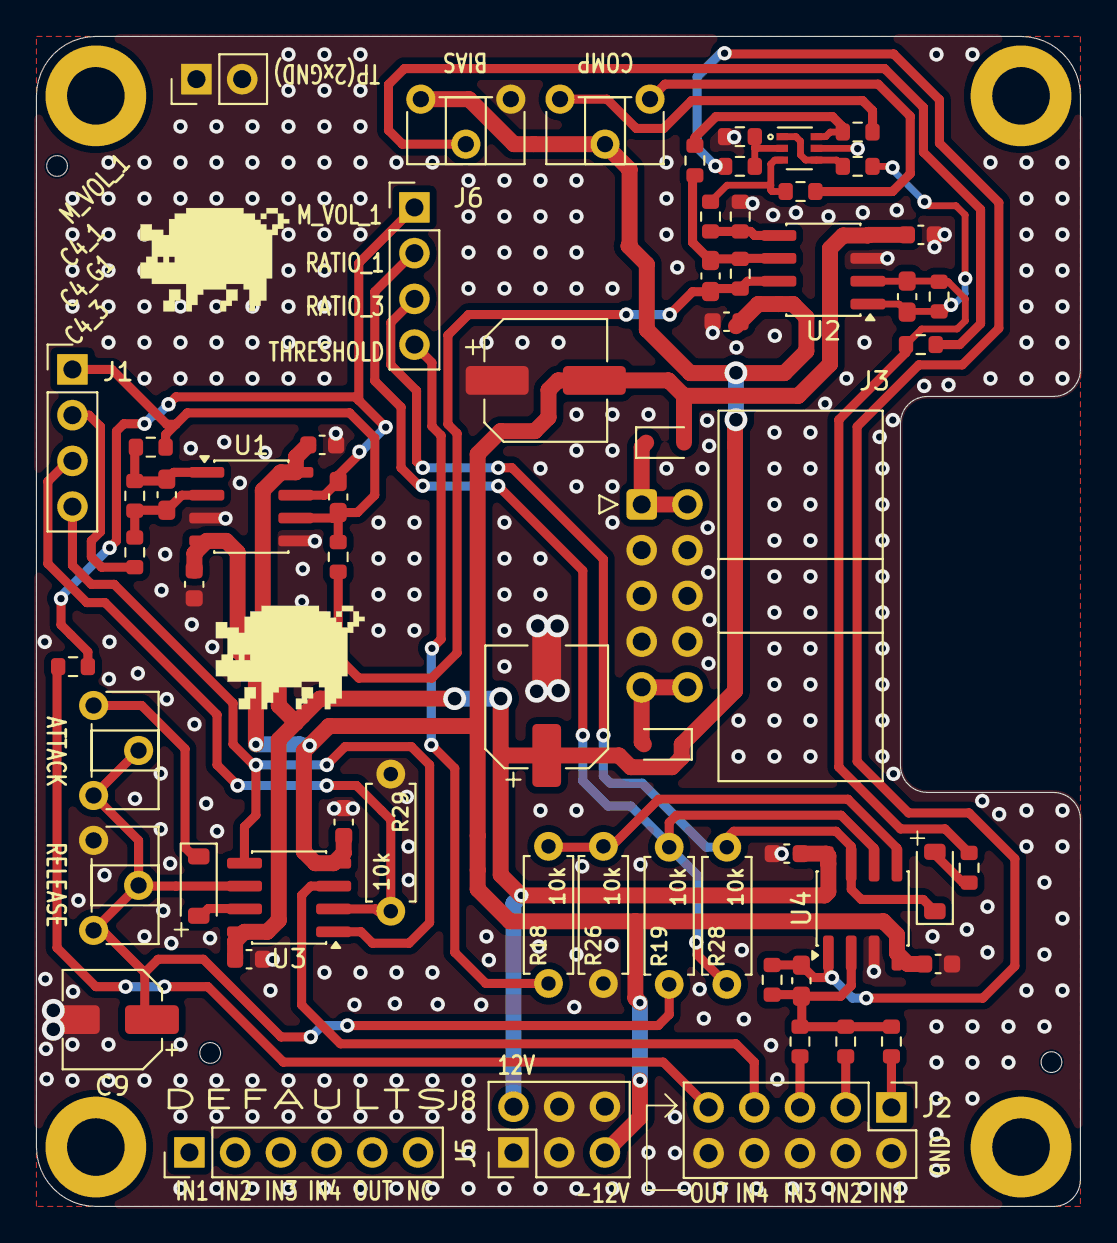
[picture p43: board sidechain-mixer-core.kicad_pcb from above]

Board: 2 copper layers, 58.0 x 65.0 mm, 66 parts (0 on the bottom side), 39 nets.
