shmoergh/moduleur/modules/04-vcf/electronics/ui/vcf-ui.kicad_pcb

## KiCad design modules/04-vcf/electronics/ui/vcf-ui.kicad_pcb (2026-05-13)

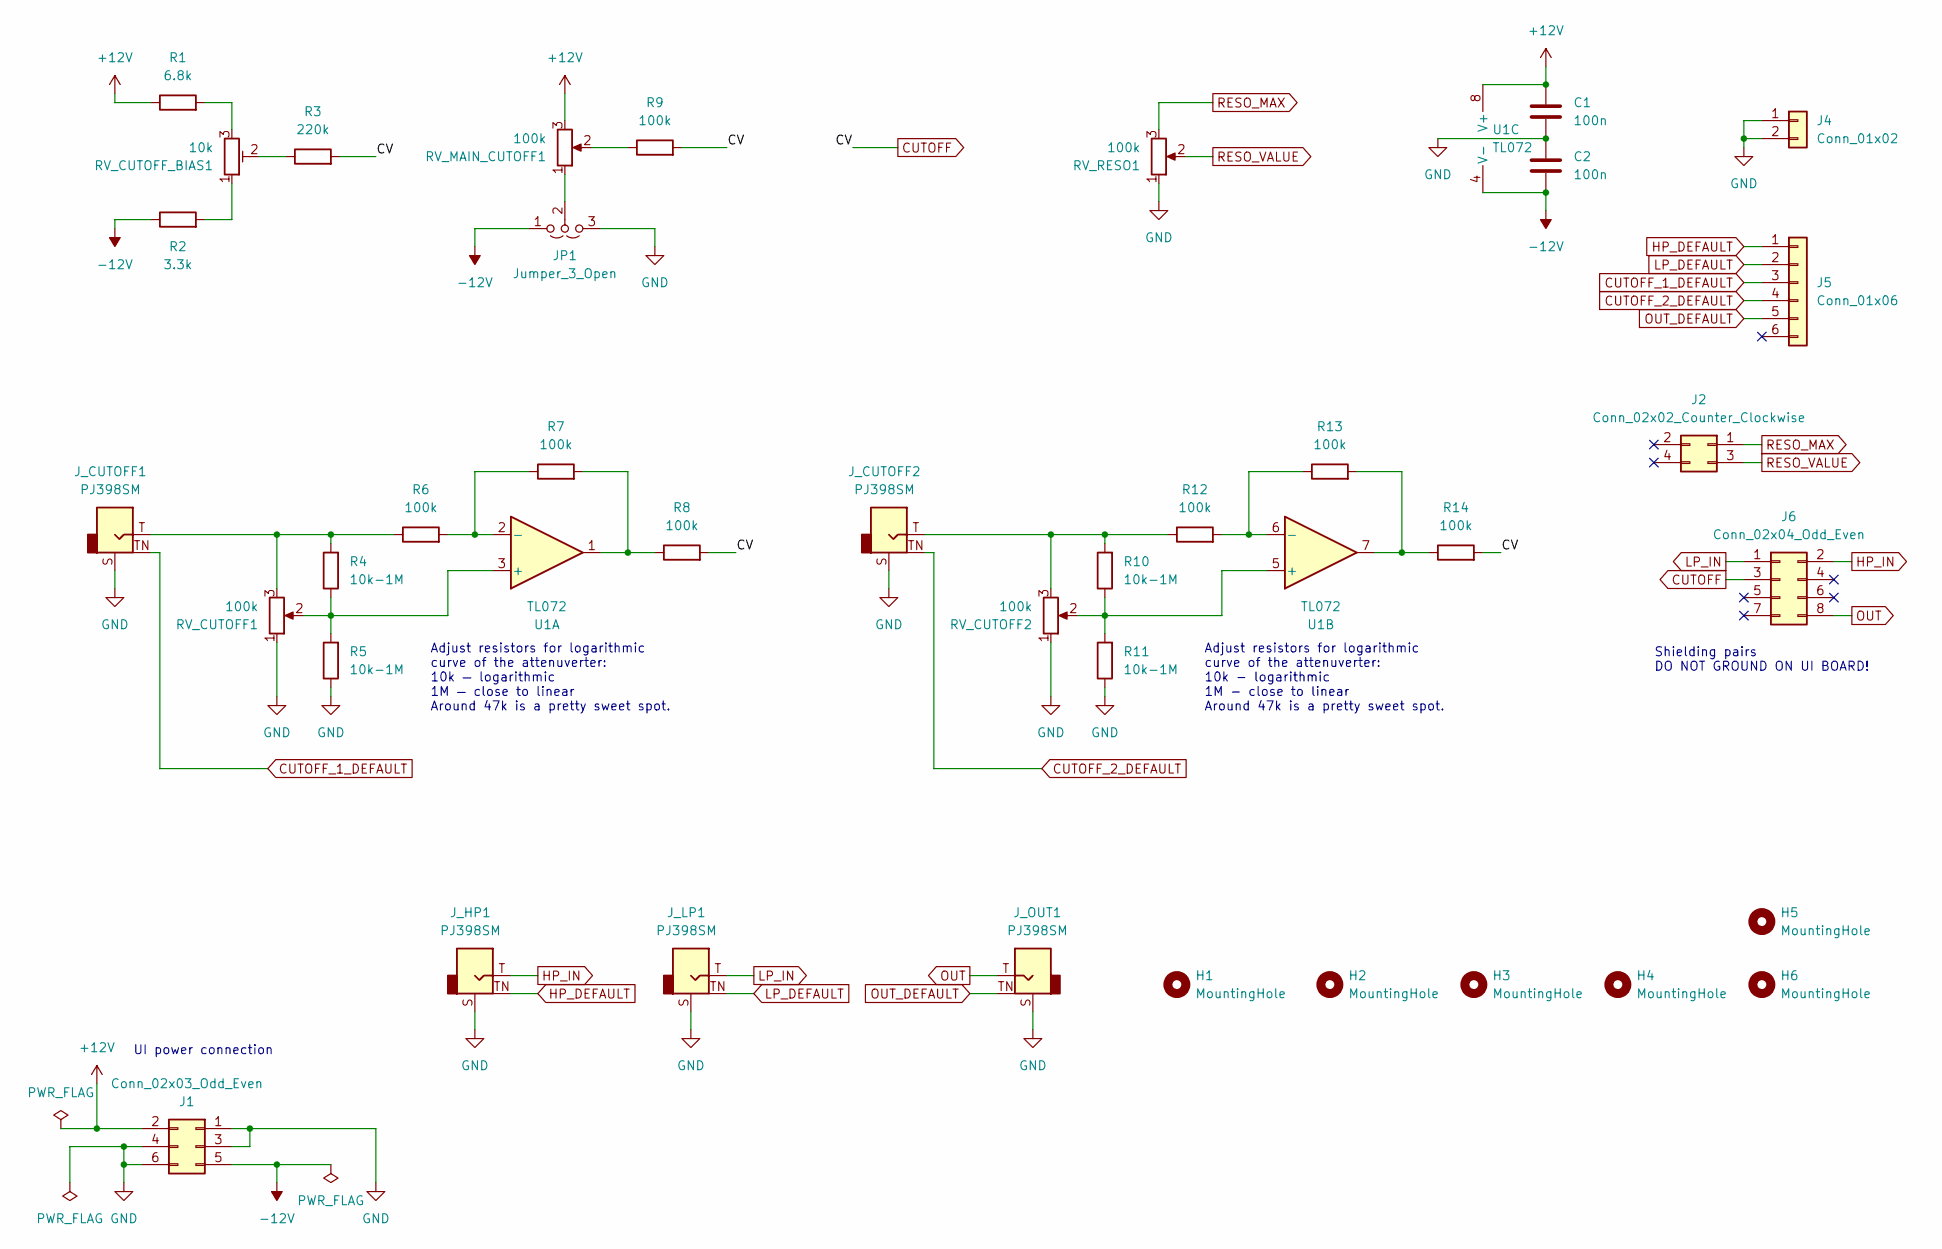
[picture p50: schematic vcf-ui.kicad_sch, Moduleur VCF UI]

Parts:
C1, C2: 100n; C_Disc_D5.0mm_W2.5mm_P2.50mm; Part no. 594-K104K15X7RF53L2
H1, H2, H3, H4, H5, H6: MountingHole; MountingHole_3.2mm_M3_DIN965_Pad
J1: Conn_02x03_Odd_Even; PinSocket_2x03_P2.54mm_Vertical; Part no. 200-SSW10301TD
J2: Conn_02x02_Counter_Clockwise; PinSocket_2x02_P2.54mm_Vertical; Part no. 200-SSW10206TD
J4: Conn_01x02; PinSocket_1x02_P2.54mm_Vertical; Part no. 200-SSW10201TS
J5: Conn_01x06; PinSocket_1x06_P2.54mm_Vertical; Part no. 200-SSW10601TS
J6: Conn_02x04_Odd_Even; PinSocket_2x04_P2.54mm_Vertical; Part no. 200-SSW10401TD
JP1: Jumper_3_Open; PinHeader_1x03_P2.54mm_Vertical
J_CUTOFF1, J_CUTOFF2: PJ398SM; Jack_3.5mm_QingPu_WQP-PJ398SM_Vertical_CircularHoles; Part no. PJ398SM
J_HP1: PJ398SM; Jack_3.5mm_QingPu_WQP-PJ398SM_Vertical_CircularHoles; Part no. PJ398SM
J_LP1: PJ398SM; Jack_3.5mm_QingPu_WQP-PJ398SM_Vertical_CircularHoles; Part no. PJ398SM
J_OUT1: PJ398SM; Jack_3.5mm_QingPu_WQP-PJ398SM_Vertical_CircularHoles; Part no. PJ398SM
R1: 6.8k; R_Axial_DIN0207_L6.3mm_D2.5mm_P7.62mm_Horizontal; Part no. 603-MFR-25FRF52100K
R2: 3.3k; R_Axial_DIN0207_L6.3mm_D2.5mm_P7.62mm_Horizontal; Part no. 603-MFR-25FRF52100K
R3: 220k; R_Axial_DIN0207_L6.3mm_D2.5mm_P7.62mm_Horizontal; Part no. 603-MFR-25FRF52100K
R4, R5, R10, R11: 10k-1M; R_Axial_DIN0207_L6.3mm_D2.5mm_P7.62mm_Horizontal; Part no. 603-MFR-25FRF52100K
R6, R7, R8, R9, R12, R13, R14: 100k; R_Axial_DIN0207_L6.3mm_D2.5mm_P7.62mm_Horizontal; Part no. 603-MFR-25FRF52100K
RV_CUTOFF1, RV_CUTOFF2: 100k; Potentiometer_Bourns_Single-PTV09A; Part no. 652-PTV09A4025UB104
RV_CUTOFF_BIAS1: 10k; Potentiometer_ACP_CA6-H2,5_Horizontal; Part no. 774-06TR4AA103CP
RV_MAIN_CUTOFF1: 100k; Potentiometer_Bourns_Single-PTV09A; Part no. 652-PTV09A4025UB104
RV_RESO1: 100k; Potentiometer_Bourns_Single-PTV09A; Part no. 652-PTV09A4025UB104
U1: TL072; DIP-8_W7.62mm_LongPads; Part no. 595-TL072CP

Connections:
+12V: C1.1, J1.2, R1.1, RV_MAIN_CUTOFF1.3, U1.8 (V+)
-12V: C2.2, J1.5, JP1.1 (A), R2.1, U1.4 (V-)
CUTOFF: J6.3, R3.2, R8.2, R9.2, R14.2
CUTOFF_1_DEFAULT: J5.3, J_CUTOFF1.TN
CUTOFF_2_DEFAULT: J5.4, J_CUTOFF2.TN
GND: C1.2, C2.1, J1.1, J1.3, J1.4, J1.6, J4.1, J4.2, JP1.3 (B), J_CUTOFF1.S, J_CUTOFF2.S, J_HP1.S, J_LP1.S, J_OUT1.S, R5.1, R11.1, RV_CUTOFF1.1, RV_CUTOFF2.1, RV_RESO1.1
HP_DEFAULT: J5.1, J_HP1.TN
HP_IN: J6.2, J_HP1.T
LP_DEFAULT: J5.2, J_LP1.TN
LP_IN: J6.1, J_LP1.T
unnamed: JP1.2 (C), RV_MAIN_CUTOFF1.1
unnamed: J_CUTOFF1.T, R4.2, R6.1, RV_CUTOFF1.3
unnamed: J_CUTOFF2.T, R10.2, R12.1, RV_CUTOFF2.3
unnamed: R1.2, RV_CUTOFF_BIAS1.3
unnamed: R2.2, RV_CUTOFF_BIAS1.1
unnamed: R3.1, RV_CUTOFF_BIAS1.2
unnamed: R7.2, R8.1, U1.1
unnamed: R9.1, RV_MAIN_CUTOFF1.2
unnamed: R13.2, R14.1, U1.7
unnamed: R4.1, R5.2, RV_CUTOFF1.2, U1.3 (+)
unnamed: R6.2, R7.1, U1.2 (-)
unnamed: R10.1, R11.2, RV_CUTOFF2.2, U1.5 (+)
unnamed: R12.2, R13.1, U1.6 (-)
OUT: J6.8, J_OUT1.T
OUT_DEFAULT: J5.5, J_OUT1.TN
RESO_MAX: J2.1, RV_RESO1.3
RESO_VALUE: J2.3, RV_RESO1.2

Notes on the sheet:
UI power connection
Adjust resistors for logarithmic curve of the attenuverter: 10k — logarithmic 1M — close to linear Around 47k is a pretty sweet spot.
Shielding pairs DO NOT GROUND ON UI BOARD!
Adjust resistors for logarithmic curve of the attenuverter: 10k - logarithmic 1M - close to linear Around 47k is a pretty sweet spot.

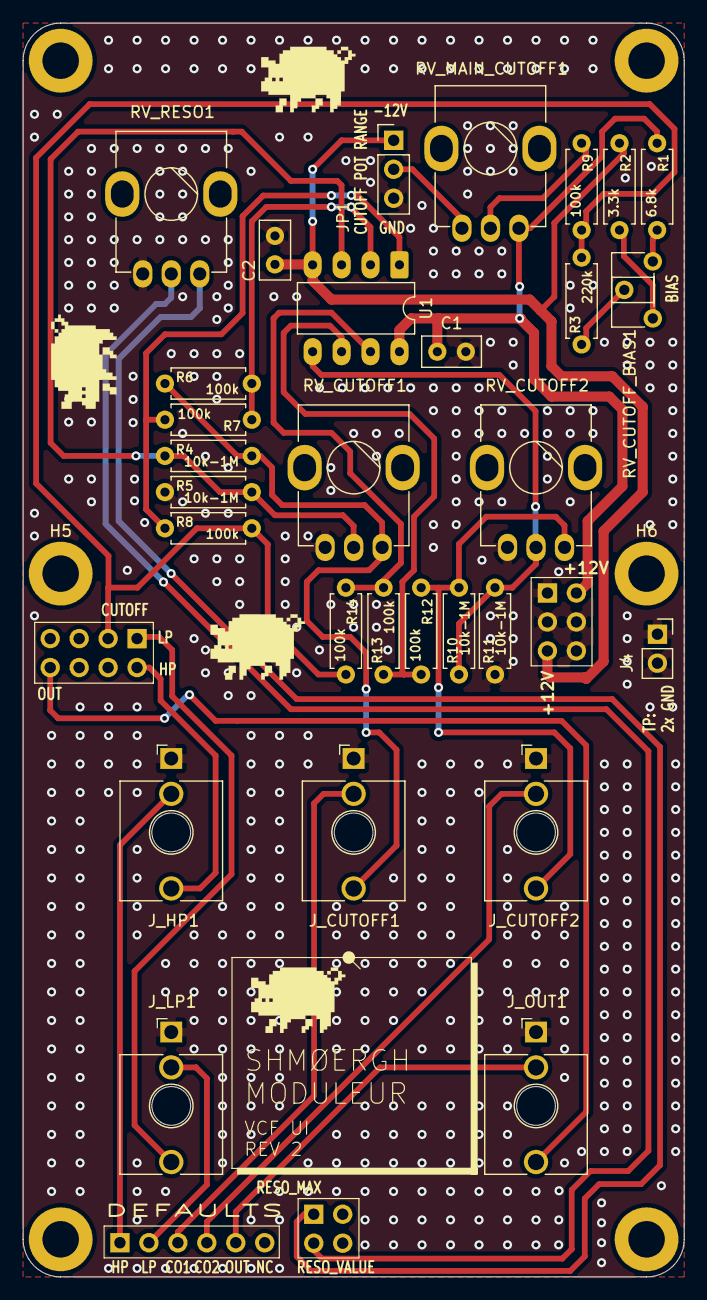
[picture p51: board vcf-ui.kicad_pcb from above]

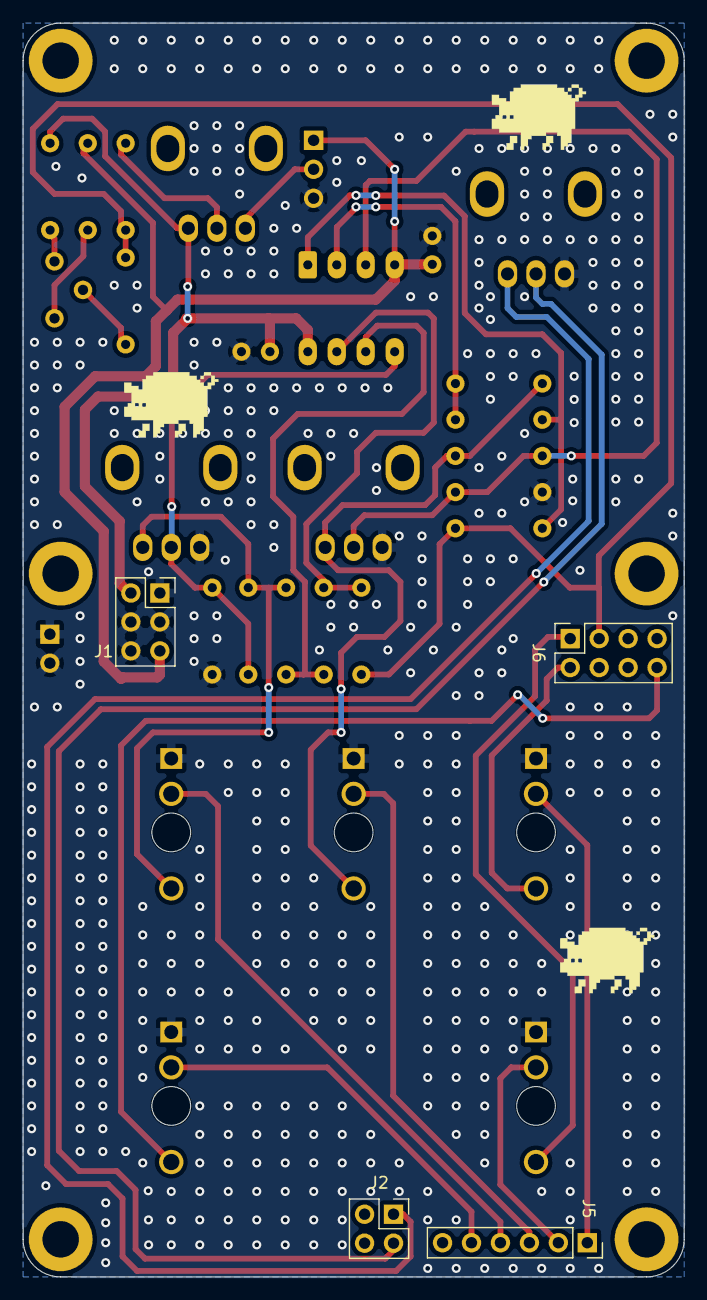
[picture p52: board vcf-ui.kicad_pcb from below]

Board: 2 copper layers, 58.0 x 110.0 mm, 39 parts (4 on the bottom side), 27 nets.
