shmoergh/moduleur/modules/03-sidechain-mixer/electronics/ui/sidechain-mixer-ui.kicad_pcb

## KiCad design modules/03-sidechain-mixer/electronics/ui/sidechain-mixer-ui.kicad_pcb (2026-05-13)

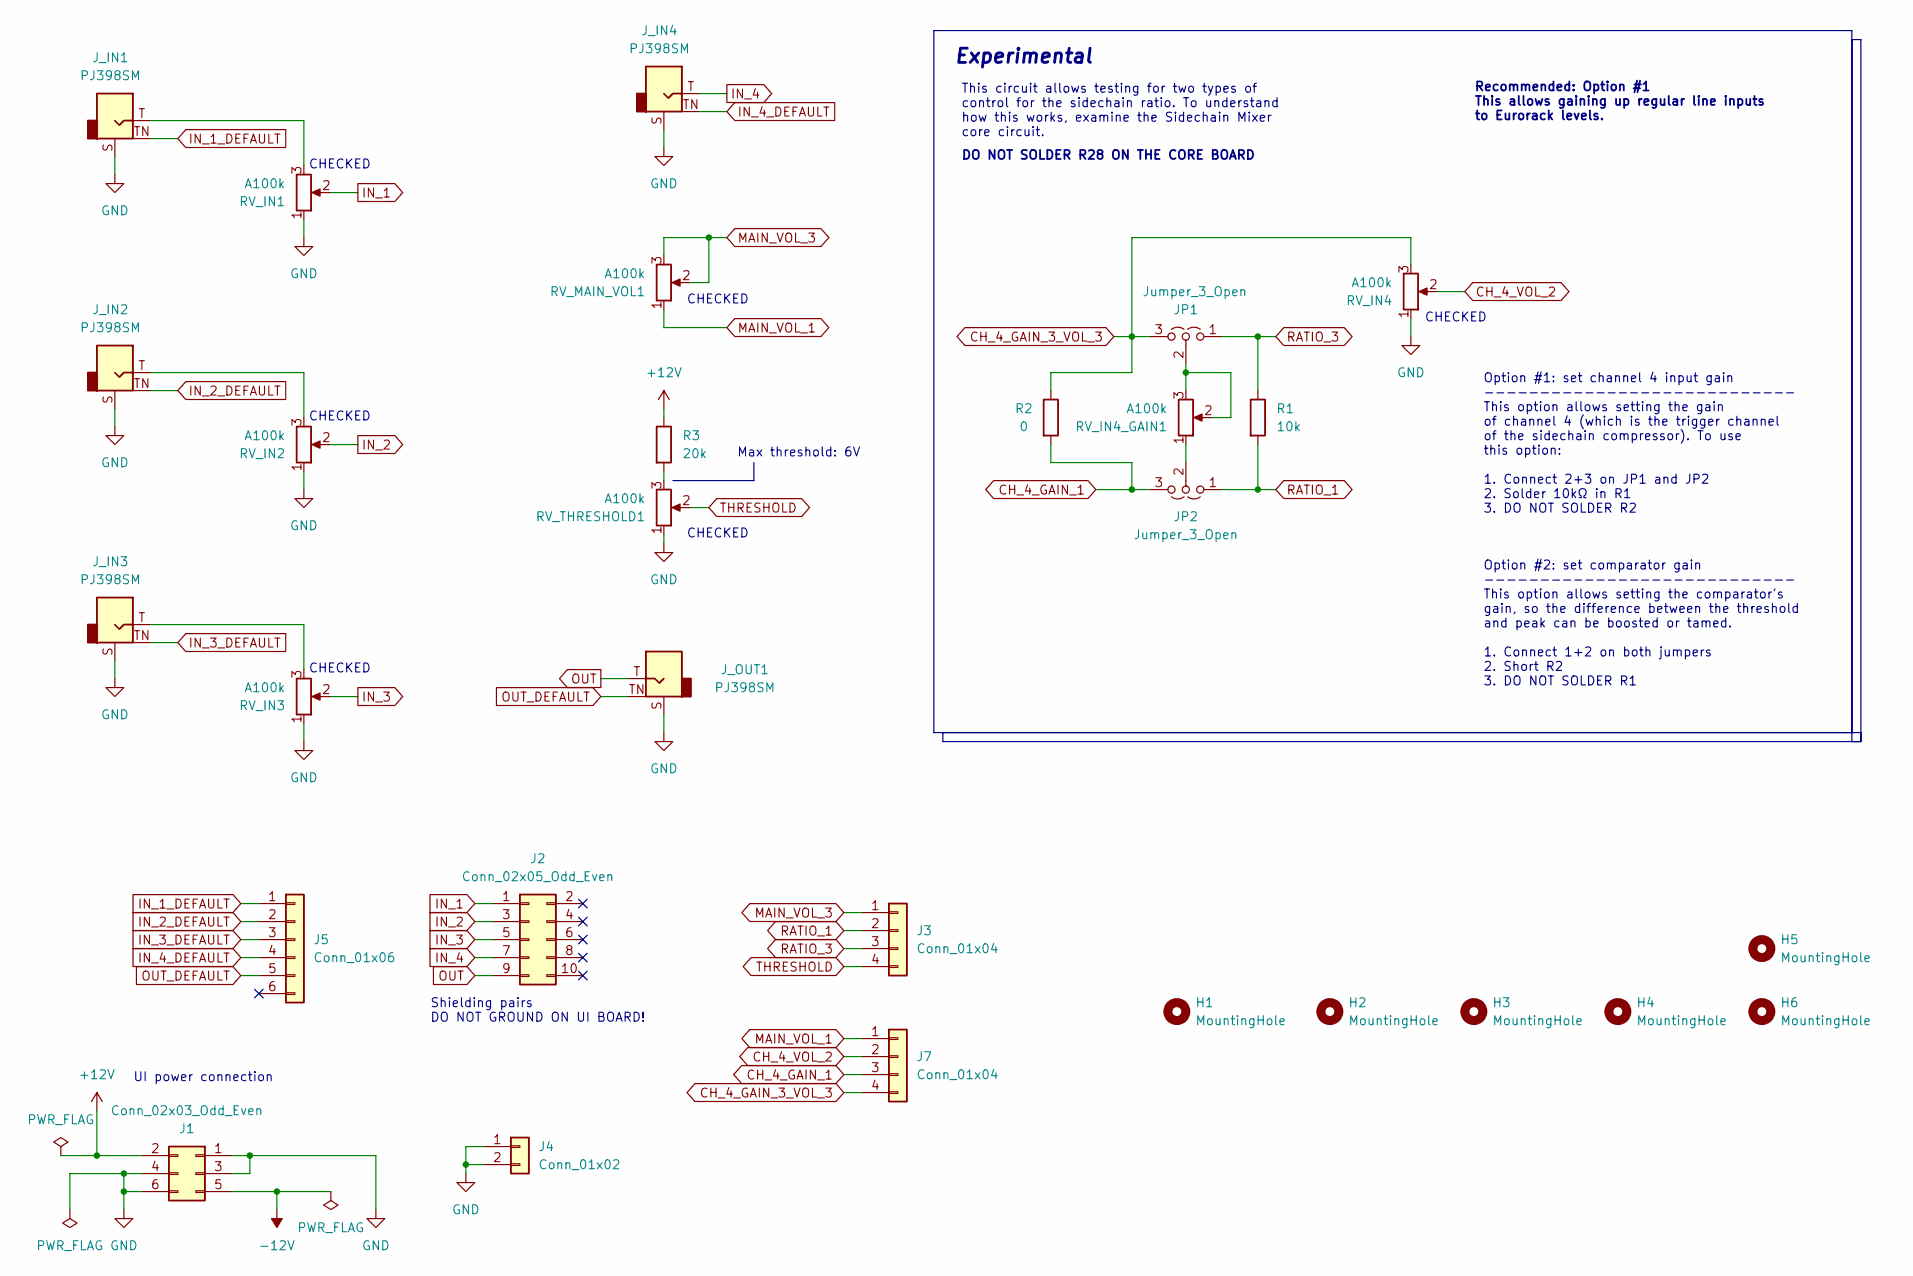
[picture p53: schematic sidechain-mixer-ui.kicad_sch, Hog Moduleur Sidechain Mixer UI]

Parts:
H1, H2, H3, H4, H5, H6: MountingHole; MountingHole_3.2mm_M3_DIN965_Pad
J1: Conn_02x03_Odd_Even; PinSocket_2x03_P2.54mm_Vertical; Part no. 200-SSW10301TD
J2: Conn_02x05_Odd_Even; PinSocket_2x05_P2.54mm_Vertical; Part no. 200-SSW10501TD
J3, J7: Conn_01x04; PinSocket_1x04_P2.54mm_Vertical; Part no. 200-SSW10401TMS
J4: Conn_01x02; PinSocket_1x02_P2.54mm_Vertical; Part no. 200-SSW10201TS
J5: Conn_01x06; PinSocket_1x06_P2.54mm_Vertical; Part no. 200-SSW10601TS
JP1, JP2: Jumper_3_Open; PinHeader_1x03_P2.54mm_Vertical
J_IN1, J_IN2, J_IN3, J_IN4: PJ398SM; Jack_3.5mm_QingPu_WQP-PJ398SM_Vertical_CircularHoles; Part no. PJ398SM
J_OUT1: PJ398SM; Jack_3.5mm_QingPu_WQP-PJ398SM_Vertical_CircularHoles; Part no. PJ398SM
R1: 10k; R_Axial_DIN0207_L6.3mm_D2.5mm_P7.62mm_Horizontal; Part no. 603-MFR-25FRF5210K
R2: 0; R_Axial_DIN0207_L6.3mm_D2.5mm_P7.62mm_Horizontal
R3: 20k; R_Axial_DIN0207_L6.3mm_D2.5mm_P7.62mm_Horizontal; Part no. 603-MFR-25FRF5220K
RV_IN1, RV_IN2, RV_IN3: A100k; TRIM_PTA3043-2010CIA503; Part no. 652-PTA30432015A104
RV_IN4, RV_IN4_GAIN1: A100k; Potentiometer_Bourns_Single-PTV09A; Part no. 652-PTV09A-4025UA104
RV_MAIN_VOL1: A100k; Potentiometer_Bourns_Single-PTV09A; Part no. 652-PTV09A-4025UA104
RV_THRESHOLD1: A100k; Potentiometer_Bourns_Single-PTV09A; Part no. 652-PTV09A-4025UA104

Connections:
+12V: J1.2, R3.1
-12V: J1.5
CH_4_GAIN_1: J7.3, JP2.3 (B), R2.2
CH_4_GAIN_3_VOL_3: J7.4, JP1.3 (B), R2.1, RV_IN4.3
CH_4_VOL_2: J7.2, RV_IN4.2
GND: J1.1, J1.3, J1.4, J1.6, J4.1, J4.2, J_IN1.S, J_IN2.S, J_IN3.S, J_IN4.S, J_OUT1.S, RV_IN1.1, RV_IN2.1, RV_IN3.1, RV_IN4.1, RV_THRESHOLD1.1
IN_1: J2.1, RV_IN1.2
IN_1_DEFAULT: J5.1, J_IN1.TN
IN_2: J2.3, RV_IN2.2
IN_2_DEFAULT: J5.2, J_IN2.TN
IN_3: J2.5, RV_IN3.2
IN_3_DEFAULT: J5.3, J_IN3.TN
IN_4: J2.7, J_IN4.T
IN_4_DEFAULT: J5.4, J_IN4.TN
MAIN_VOL_1: J7.1, RV_MAIN_VOL1.1
MAIN_VOL_3: J3.1, RV_MAIN_VOL1.2, RV_MAIN_VOL1.3
unnamed: JP1.2 (C), RV_IN4_GAIN1.2, RV_IN4_GAIN1.3
unnamed: JP2.2 (C), RV_IN4_GAIN1.1
unnamed: J_IN1.T, RV_IN1.3
unnamed: J_IN2.T, RV_IN2.3
unnamed: J_IN3.T, RV_IN3.3
unnamed: R3.2, RV_THRESHOLD1.3
OUT: J2.9, J_OUT1.T
OUT_DEFAULT: J5.5, J_OUT1.TN
RATIO_1: J3.2, JP2.1 (A), R1.2
RATIO_3: J3.3, JP1.1 (A), R1.1
THRESHOLD: J3.4, RV_THRESHOLD1.2

Notes on the sheet:
Recommended: Option #1 This allows gaining up regular line inputs to Eurorack levels.
Option #2: set comparator gain ---------------------------- This option allows setting the comparator's gain, so the difference between the threshold and peak can be boosted or tamed. 1. Connect 1+2 on both jumpers 2. Short R2 3. DO NOT SOLDER R1
Max threshold: 6V
CHECKED
This circuit allows testing for two types of control for the sidechain ratio. To understand how this works, examine the Sidechain Mixer core circuit.
UI power connection
Option #1: set channel 4 input gain ---------------------------- This option allows setting the gain of channel 4 (which is the trigger channel of the sidechain compressor). To use this option: 1. Connect 2+3 on JP1 and JP2 2. Solder 10kΩ in R1 3. DO NOT SOLDER R2
DO NOT SOLDER R28 ON THE CORE BOARD
Experimental
Shielding pairs DO NOT GROUND ON UI BOARD!

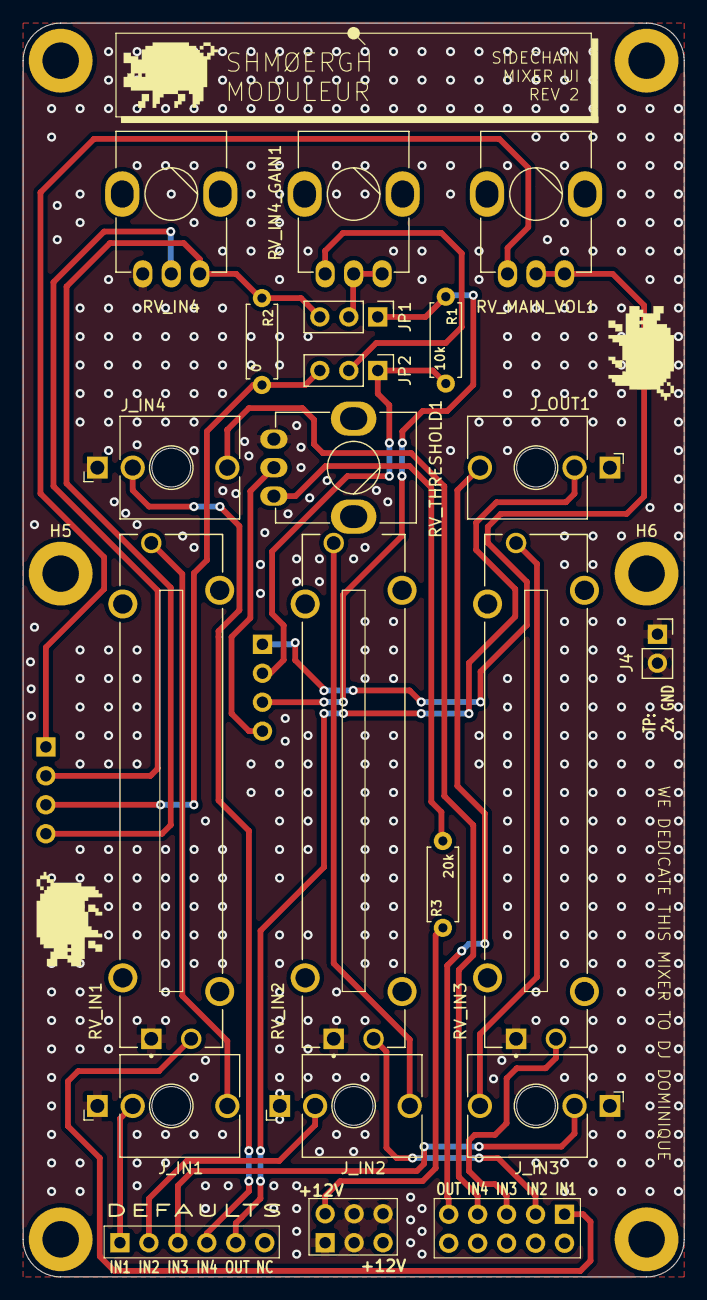
[picture p54: board sidechain-mixer-ui.kicad_pcb from above]

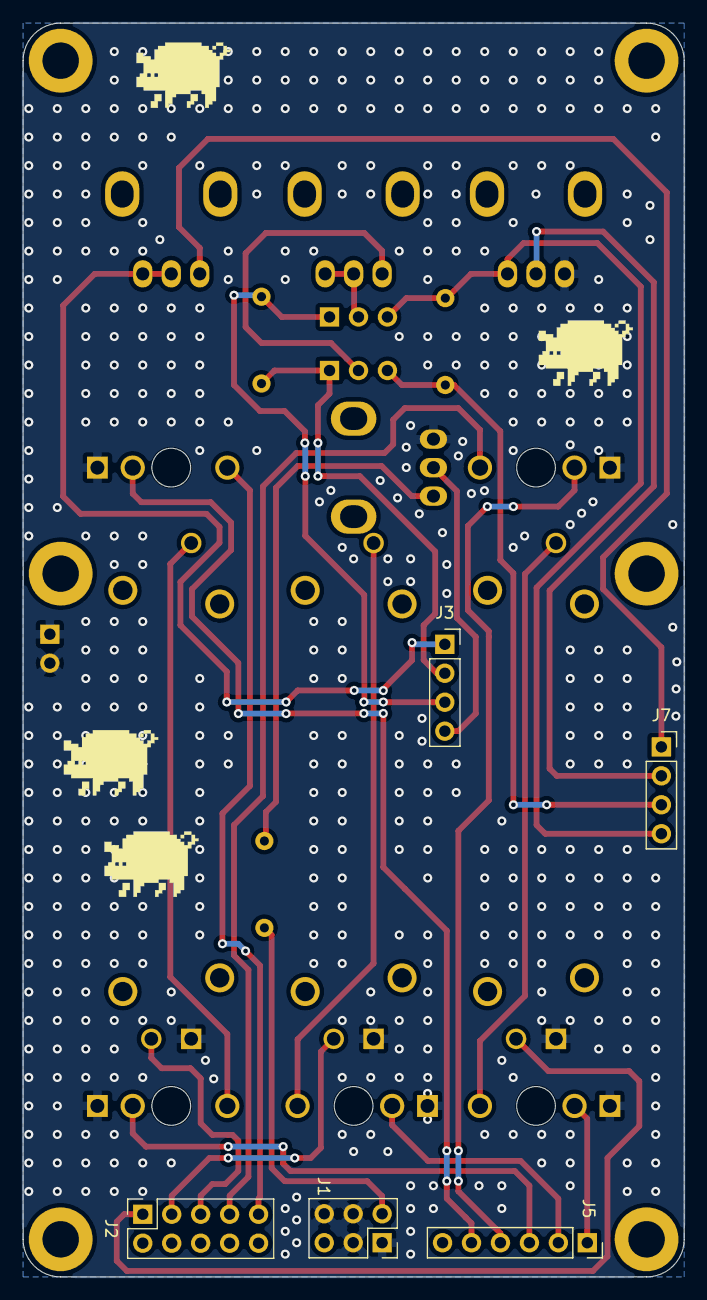
[picture p55: board sidechain-mixer-ui.kicad_pcb from below]

Board: 2 copper layers, 58.0 x 110.0 mm, 29 parts (5 on the bottom side), 26 nets.
