shmoergh/moduleur/modules/02-vco/electronics/ui/vco-ui.kicad_pcb

## KiCad design modules/02-vco/electronics/ui/vco-ui.kicad_pcb (2026-05-13)

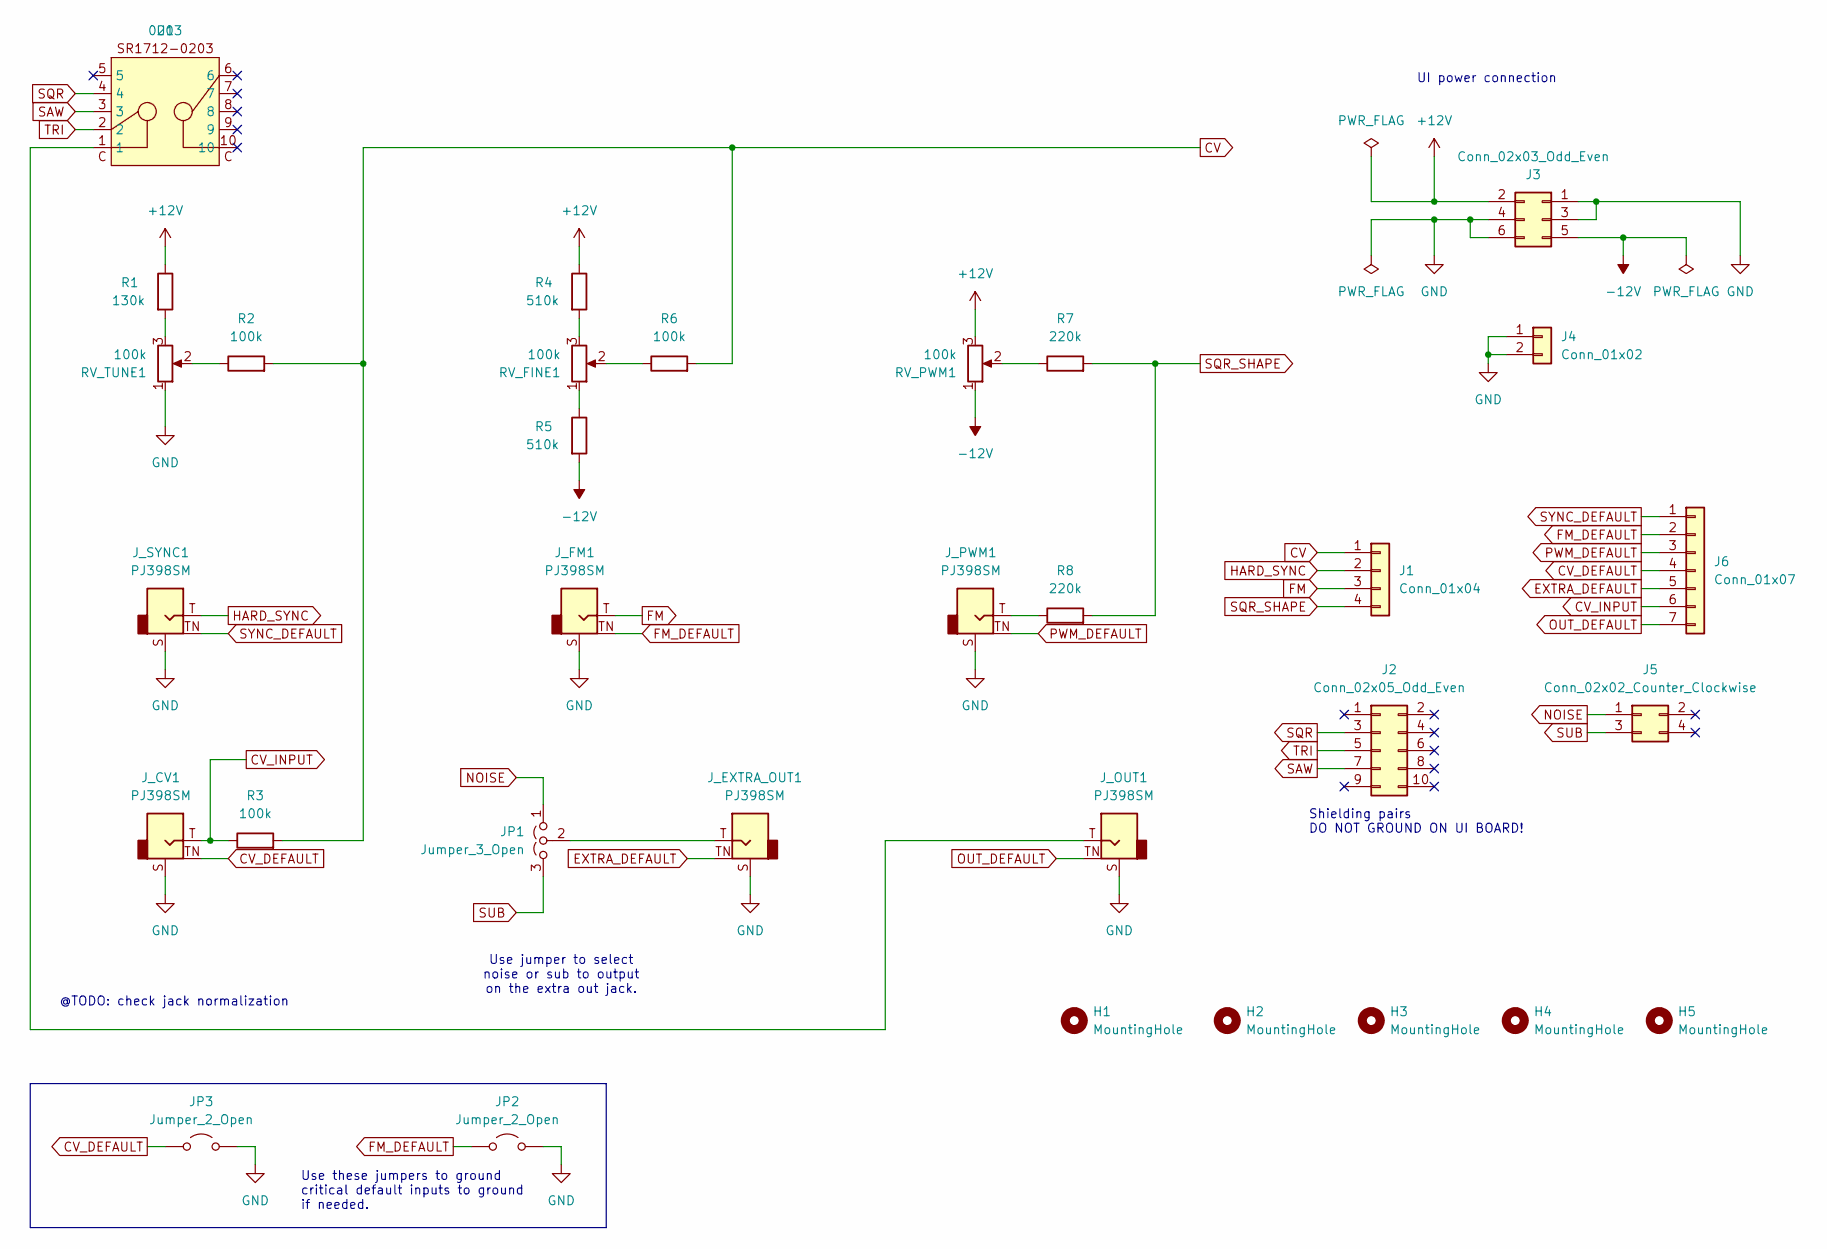
[picture p59: schematic vco-ui.kicad_sch, Moduleur VCO UI]

Parts:
H1, H2, H3, H4, H5: MountingHole; MountingHole_3.2mm_M3_DIN965_Pad
J1: Conn_01x04; PinSocket_1x04_P2.54mm_Vertical; Part no. 200-SSW10401TMS
J2: Conn_02x05_Odd_Even; PinSocket_2x05_P2.54mm_Vertical; Part no. 200-SSW10501TD
J3: Conn_02x03_Odd_Even; PinSocket_2x03_P2.54mm_Vertical; Part no. 200-SSW10301TD
J4: Conn_01x02; PinSocket_1x02_P2.54mm_Vertical; Part no. 200-SSW10201TS
J5: Conn_02x02_Counter_Clockwise; PinSocket_2x02_P2.54mm_Vertical; Part no. 200-SSW10206TD
J6: Conn_01x07; PinSocket_1x07_P2.54mm_Vertical; Part no. 200-SSW10601TS
JP1: Jumper_3_Open; PinHeader_1x03_P2.54mm_Horizontal; Part no. 200-HTSW10308TSRA
JP2, JP3: Jumper_2_Open; PinHeader_1x02_P2.54mm_Horizontal; Part no. 200-HTSW10208TSRA
J_CV1: PJ398SM; Jack_3.5mm_QingPu_WQP-PJ398SM_Vertical_CircularHoles; Part no. PJ398SM
J_EXTRA_OUT1: PJ398SM; Jack_3.5mm_QingPu_WQP-PJ398SM_Vertical_CircularHoles; Part no. PJ398SM
J_FM1: PJ398SM; Jack_3.5mm_QingPu_WQP-PJ398SM_Vertical_CircularHoles; Part no. PJ398SM
J_OUT1: PJ398SM; Jack_3.5mm_QingPu_WQP-PJ398SM_Vertical_CircularHoles; Part no. PJ398SM
J_PWM1: PJ398SM; Jack_3.5mm_QingPu_WQP-PJ398SM_Vertical_CircularHoles; Part no. PJ398SM
J_SYNC1: PJ398SM; Jack_3.5mm_QingPu_WQP-PJ398SM_Vertical_CircularHoles; Part no. PJ398SM
R1: 130k; R_Axial_DIN0207_L6.3mm_D2.5mm_P7.62mm_Horizontal; Part no. 603-MFR-25FBF52-130K
R2, R3, R6: 100k; R_Axial_DIN0207_L6.3mm_D2.5mm_P7.62mm_Horizontal; Part no. 603-MFR-25FRF52100K
R4, R5: 510k; R_Axial_DIN0207_L6.3mm_D2.5mm_P7.62mm_Horizontal; Part no. 603-MFR-25FBF52-510K
R7, R8: 220k; R_Axial_DIN0207_L6.3mm_D2.5mm_P7.62mm_Horizontal; Part no. 603-MFR-25FRF52-220K
RV_FINE1: 100k; Potentiometer_Bourns_Single-PTV09A; Part no. 652-PTV09A4025UB104
RV_PWM1: 100k; Potentiometer_Bourns_Single-PTV09A; Part no. 652-PTV09A4025UB104
RV_TUNE1: 100k; Potentiometer_Bourns_Single-PTV09A; Part no. 652-PTV09A4025UB104
U1: 0203; SR1712-0203; Part no. 105-SR1712F-23NS

Connections:
+12V: J3.2, R1.1, R4.1, RV_PWM1.3
-12V: J3.5, R5.2, RV_PWM1.1
CV: J1.1, R2.2, R3.2, R6.2
CV_DEFAULT: J6.4, JP3.1 (A), J_CV1.TN
CV_INPUT: J6.6, J_CV1.T, R3.1
EXTRA_DEFAULT: J6.5, J_EXTRA_OUT1.TN
FM: J1.3, J_FM1.T
FM_DEFAULT: J6.2, JP2.1 (A), J_FM1.TN
GND: J3.1, J3.3, J3.4, J3.6, J4.1, J4.2, JP2.2 (B), JP3.2 (B), J_CV1.S, J_EXTRA_OUT1.S, J_FM1.S, J_OUT1.S, J_PWM1.S, J_SYNC1.S, RV_TUNE1.1
HARD_SYNC: J1.2, J_SYNC1.T
NOISE: J5.1, JP1.1 (A)
unnamed: JP1.2 (C), J_EXTRA_OUT1.T
unnamed: J_OUT1.T, U1.1
unnamed: J_PWM1.T, R8.1
unnamed: R1.2, RV_TUNE1.3
unnamed: R2.1, RV_TUNE1.2
unnamed: R4.2, RV_FINE1.3
unnamed: R5.1, RV_FINE1.1
unnamed: R6.1, RV_FINE1.2
unnamed: R7.1, RV_PWM1.2
OUT_DEFAULT: J6.7, J_OUT1.TN
PWM_DEFAULT: J6.3, J_PWM1.TN
SAW: J2.7, U1.3
SQR: J2.3, U1.4
SQR_SHAPE: J1.4, R7.2, R8.2
SUB: J5.3, JP1.3 (B)
SYNC_DEFAULT: J6.1, J_SYNC1.TN
TRI: J2.5, U1.2

Notes on the sheet:
@TODO: check jack normalization
Use these jumpers to ground critical default inputs to ground if needed.
UI power connection
Use jumper to select noise or sub to output on the extra out jack.
Shielding pairs DO NOT GROUND ON UI BOARD!

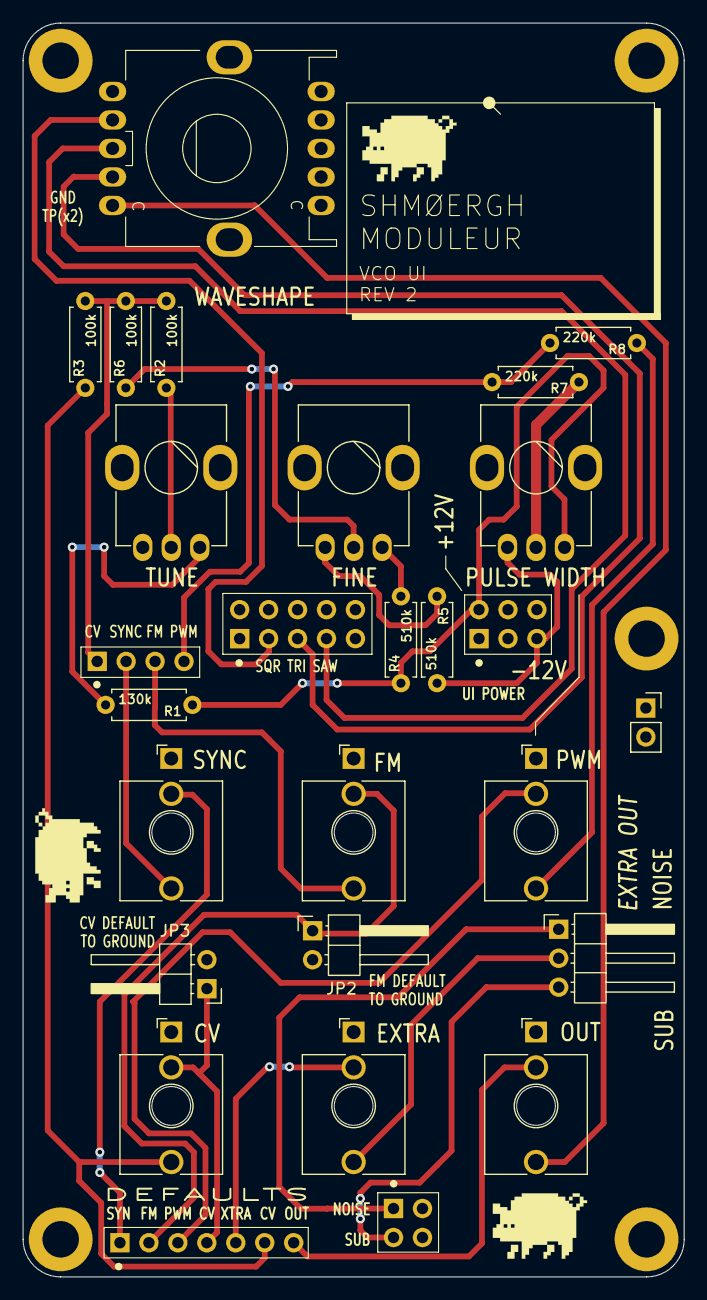
[picture p60: board vco-ui.kicad_pcb from above]

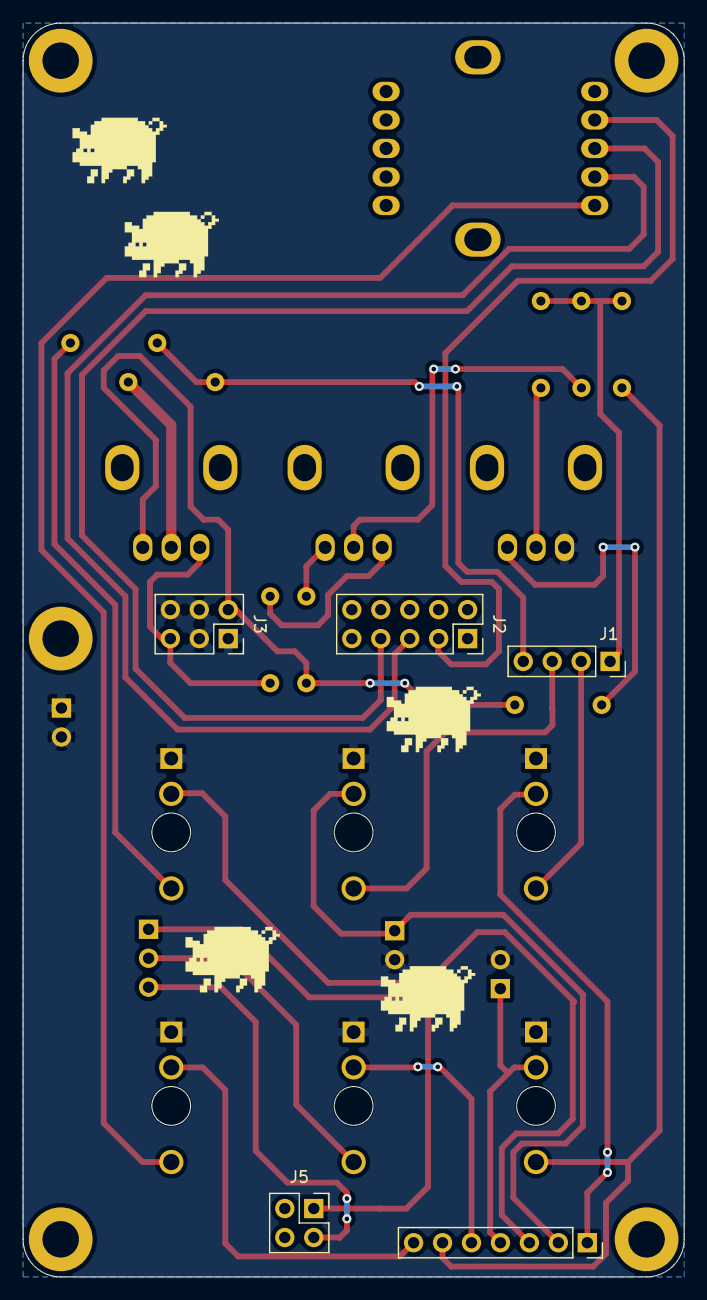
[picture p61: board vco-ui.kicad_pcb from below]

Board: 2 copper layers, 58.0 x 110.0 mm, 32 parts (5 on the bottom side), 28 nets.
