shmoergh/moduleur/accessories/multiples-attenuator/attenuator-multiple.kicad_pcb

## KiCad design accessories/multiples-attenuator/attenuator-multiple.kicad_pcb (2026-04-19)

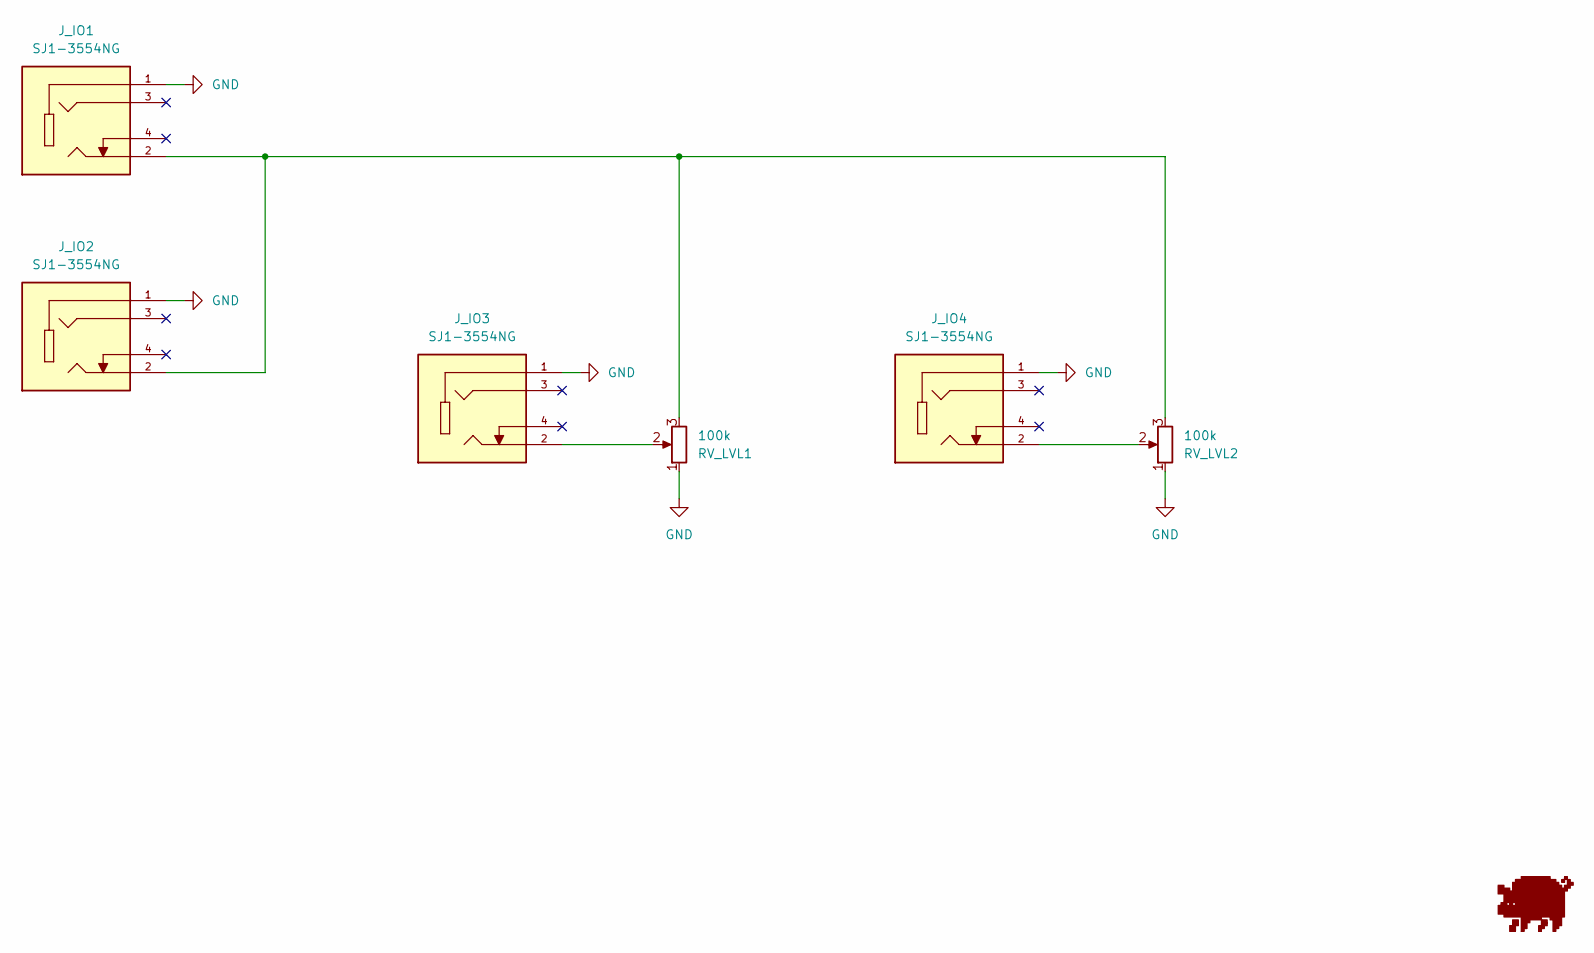
[picture p62: schematic attenuator-multiple.kicad_sch]

Parts:
J_IO1, J_IO2, J_IO3, J_IO4: SJ1-3554NG; CUI_SJ1-3554NG; PARTREV 1.05
RV_LVL1, RV_LVL2: 100k; Potentiometer_Bourns_Single-PTV09A; Part no. 652-PTV09A4025UB104
U1: Gyeszno

Connections:
GND: J_IO1.1, J_IO2.1, J_IO3.1, J_IO4.1, RV_LVL1.1, RV_LVL2.1
unnamed: J_IO1.2, J_IO2.2, RV_LVL1.3, RV_LVL2.3
unnamed: J_IO3.2, RV_LVL1.2
unnamed: J_IO4.2, RV_LVL2.2

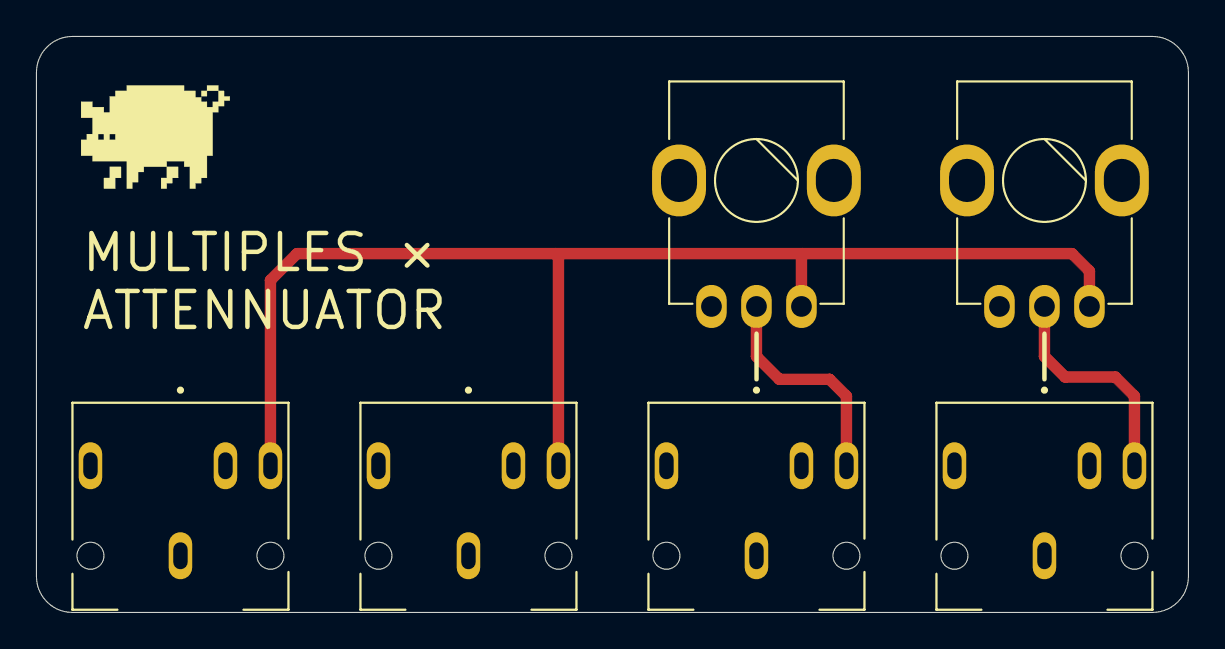
[picture p63: board attenuator-multiple.kicad_pcb from above]

Board: 2 copper layers, 64.0 x 32.0 mm, 7 parts (0 on the bottom side), 4 nets.
